tsukolsky/SeniorDesign/Files/FirstSemester/PNseries_Delorme.jpg

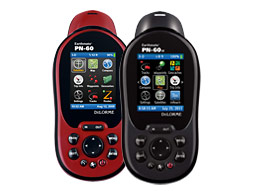
Files/FirstSemester/PNseries_Delorme.jpg
