tsukolsky/SeniorDesign/Files/FirstSemester/visualScreen.jpg

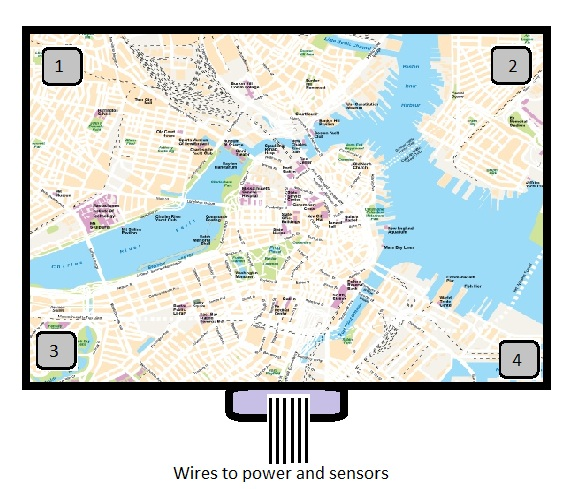
Files/FirstSemester/visualScreen.jpg
