tsukolsky/SeniorDesign/Files/powerpoints/toddsCriticalDesignReviewSlides.pptx

## Completed Items

- BeagleBone functionality
  - Modified Angstrom Kernel, boot time ~ 8 seconds. Minimal Ubuntu in ~2 seconds
  - Communication to Watchdog AVR
  - GPS Streaming, location parsing, time recognition and forwarding
- PCB schematic and layout, arrives by March 15
  - BOM ordered, arrives by March 15
- Graphics AVR functionality
  - Speed/Distance calculation using reed-switch
  - Communication from Watchdog AVR
  - HR Monitoring
  - Trip feature
- Watchdog AVR functionality
  - Real Time Clock
  - Communication from BeagleBone, to Graphics AVR
  - Battery Monitoring and power distribution
  - Temperature Sensing

## Real Time Clock UML

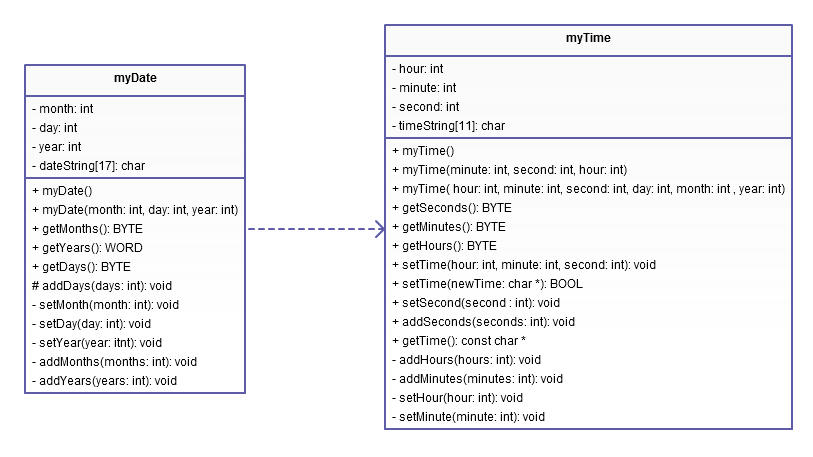
[picture p3: figure]

## Bone to WAVR Communication

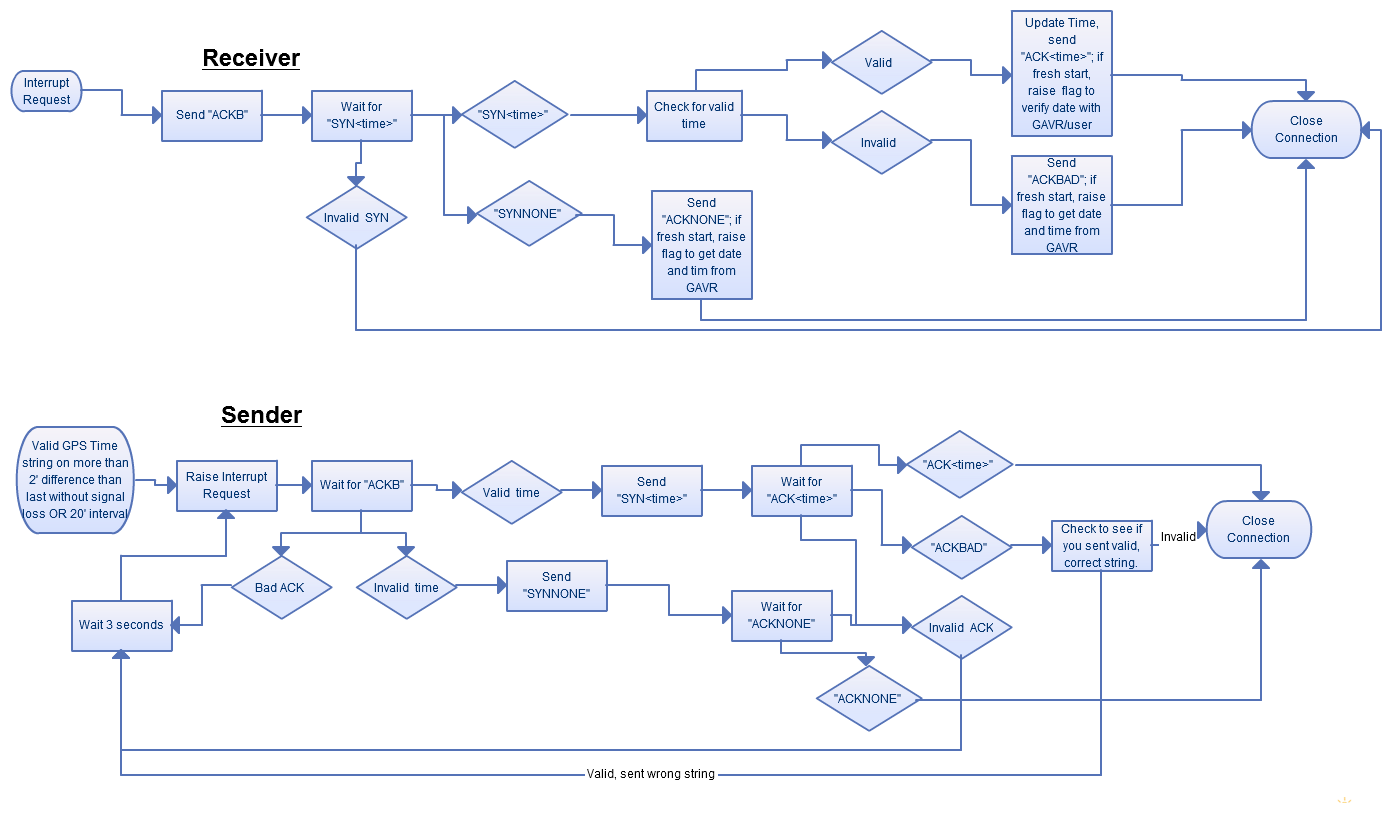
[picture p4: figure]

## WAVR to GAVR Communication

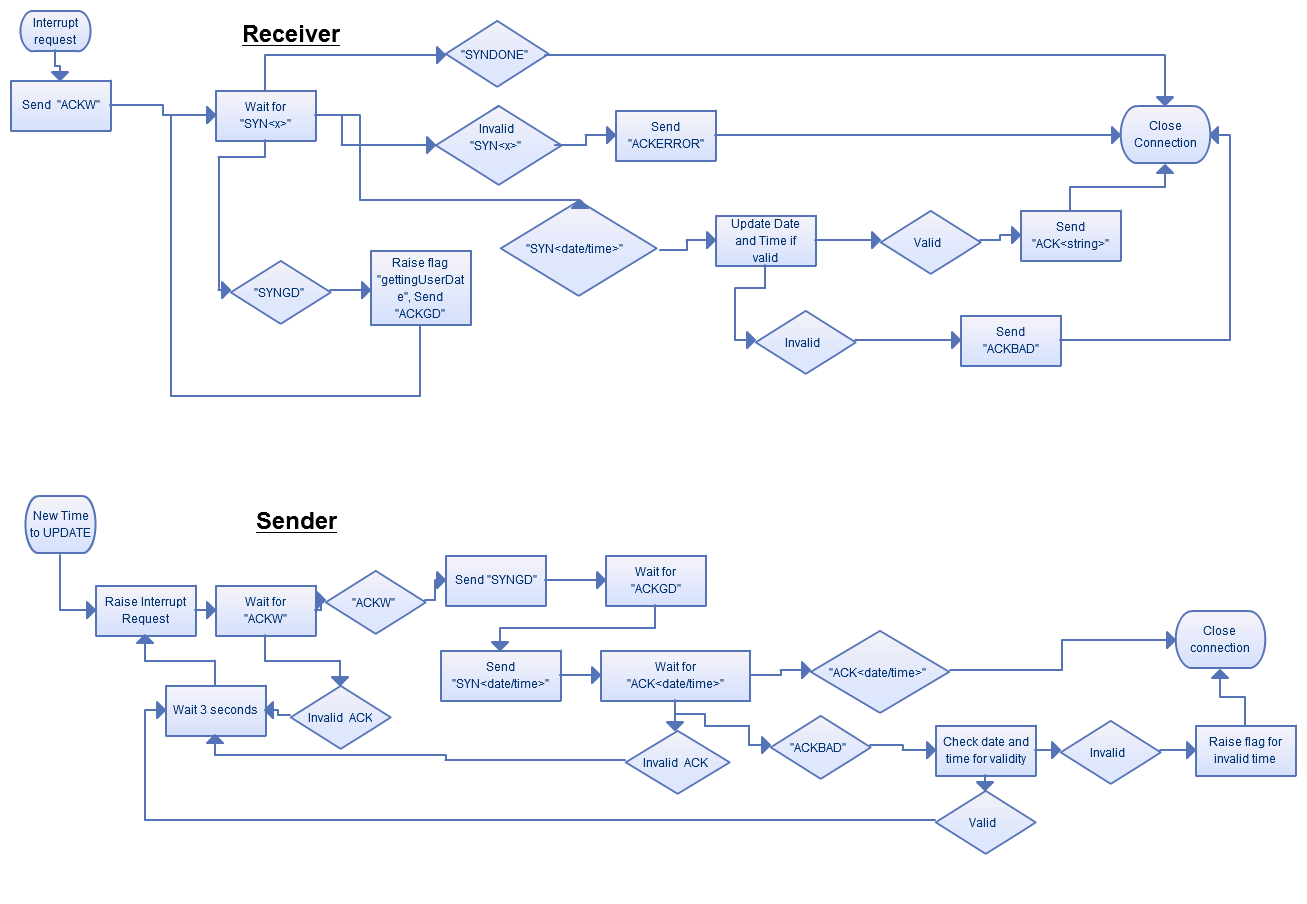
[picture p5: figure]

## Trip Feature UML

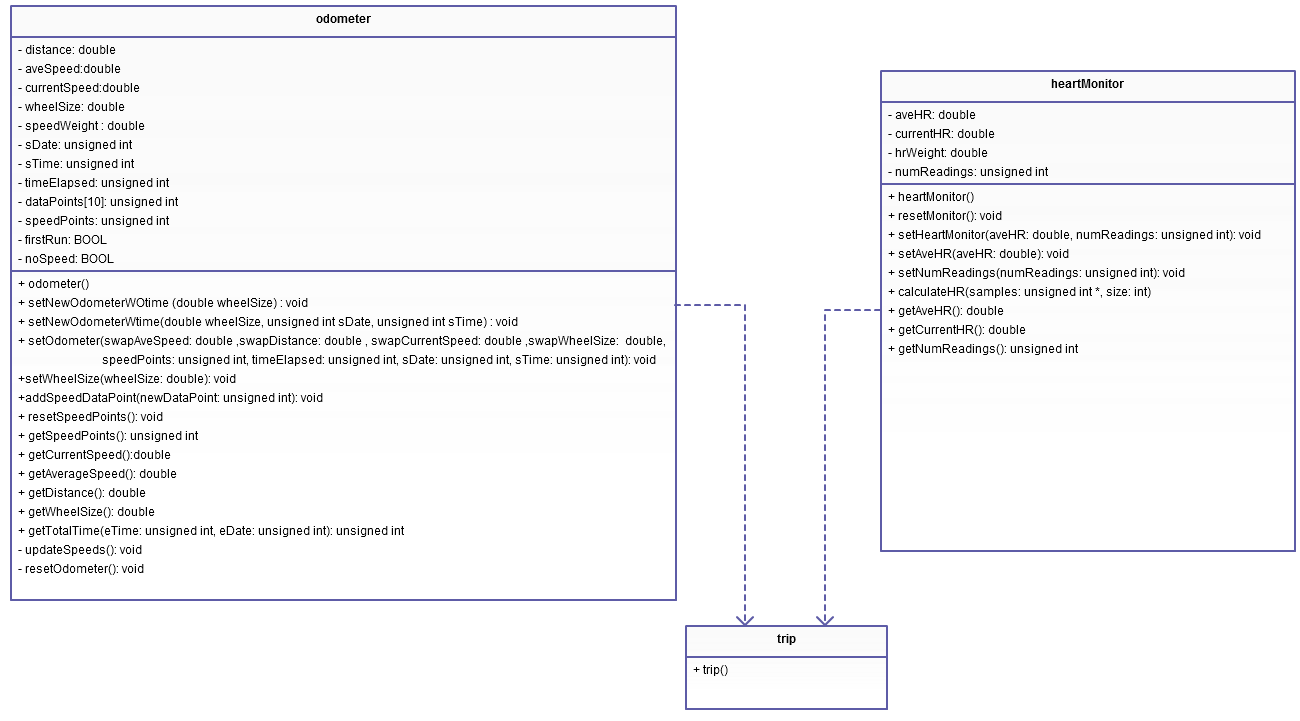
[picture p6: figure]

## Trip Flow and Data Structure

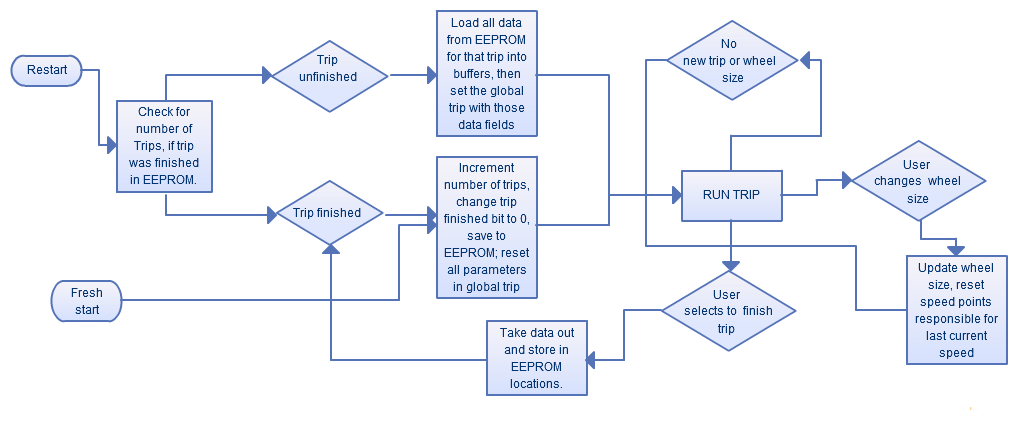
[picture p7: figure]
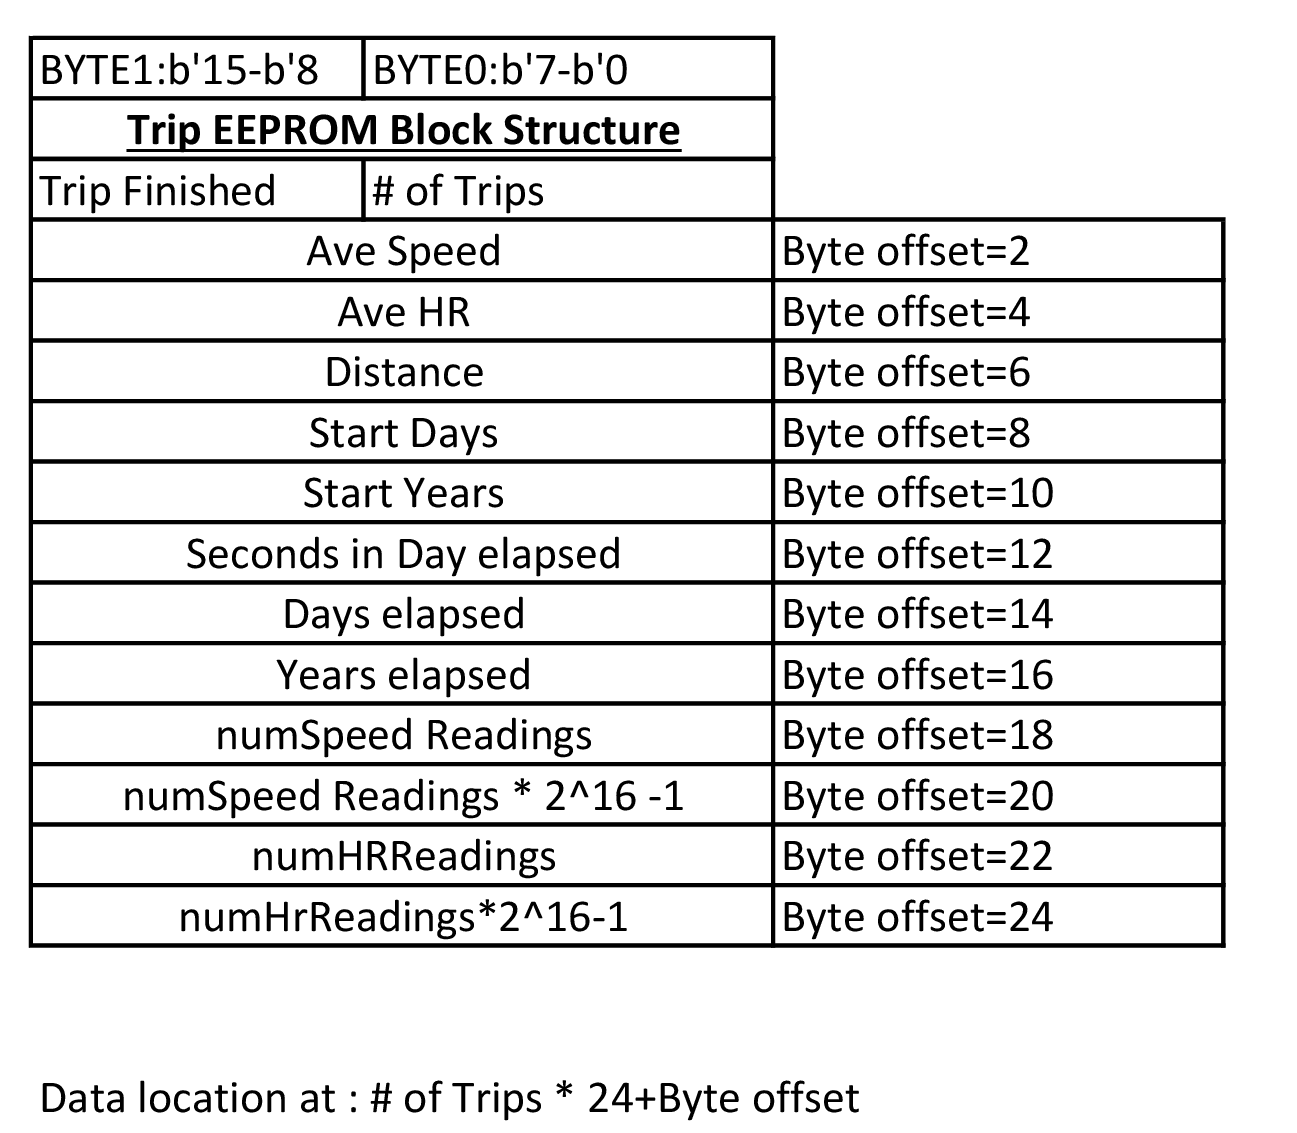
[picture p8: figure]

## Slide 7

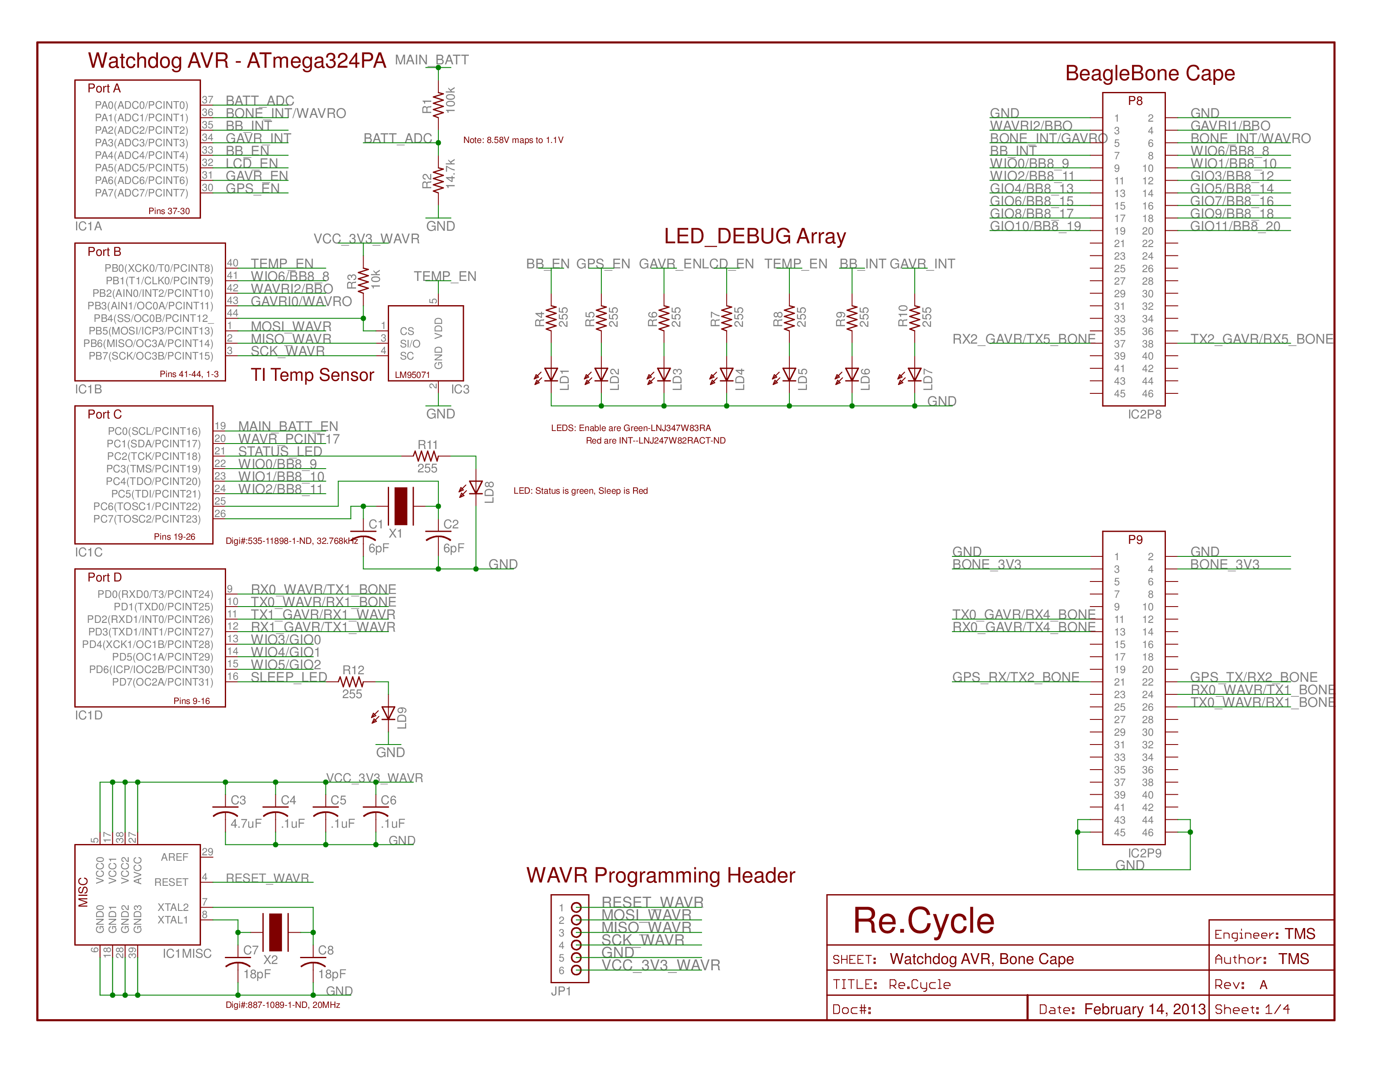
[picture p9: figure]

## Slide 8

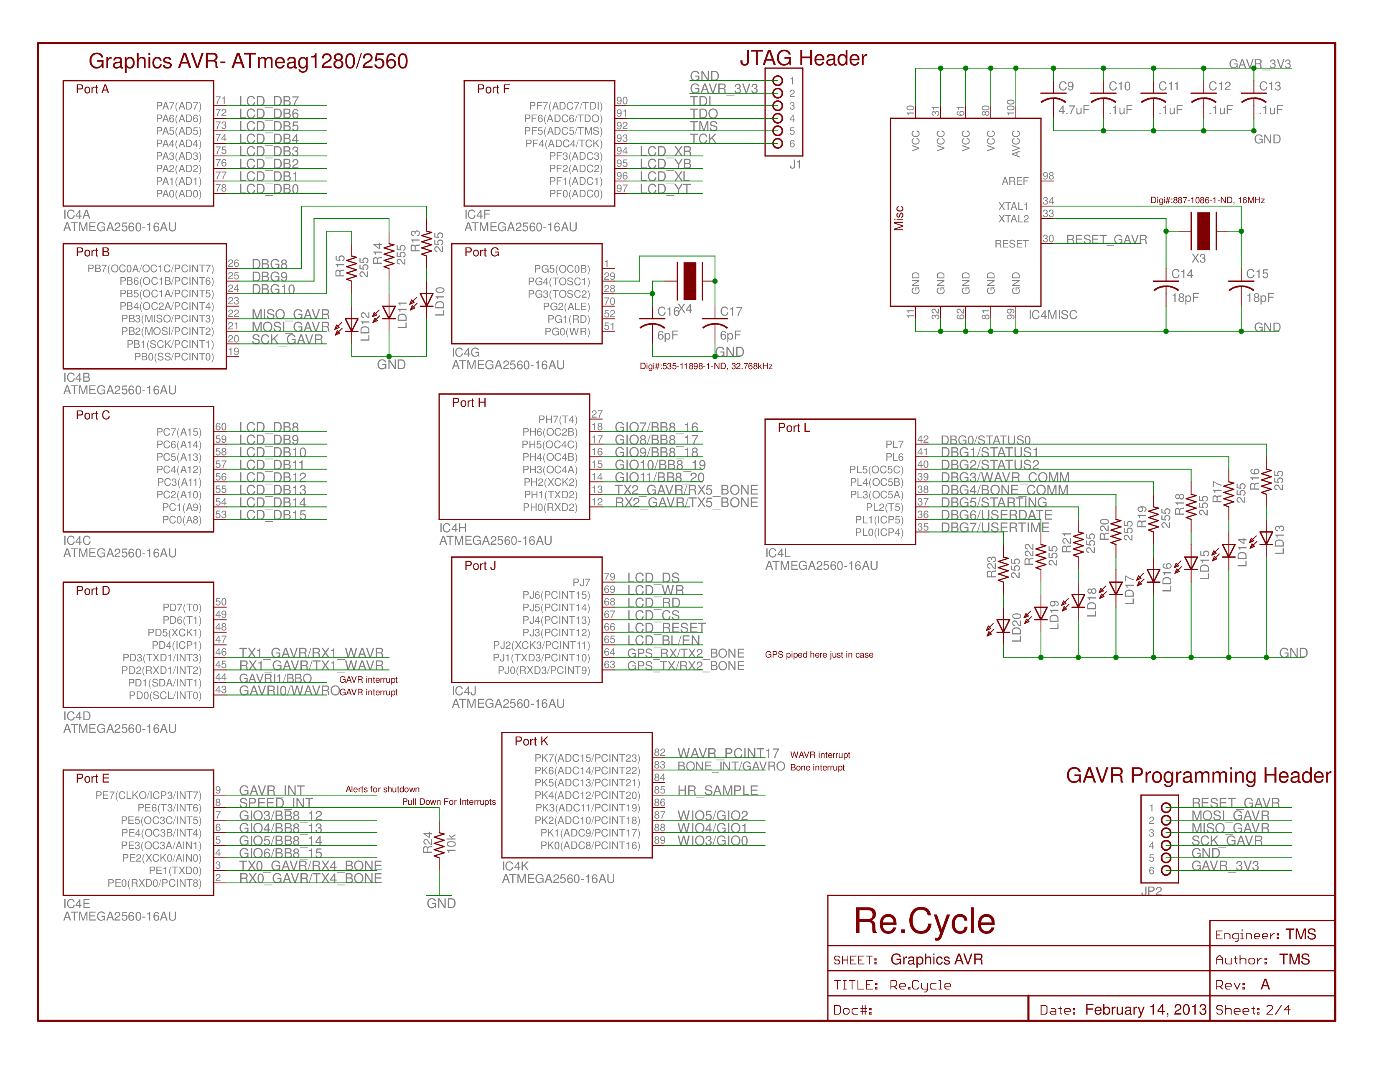
[picture p10: figure]

## Slide 9

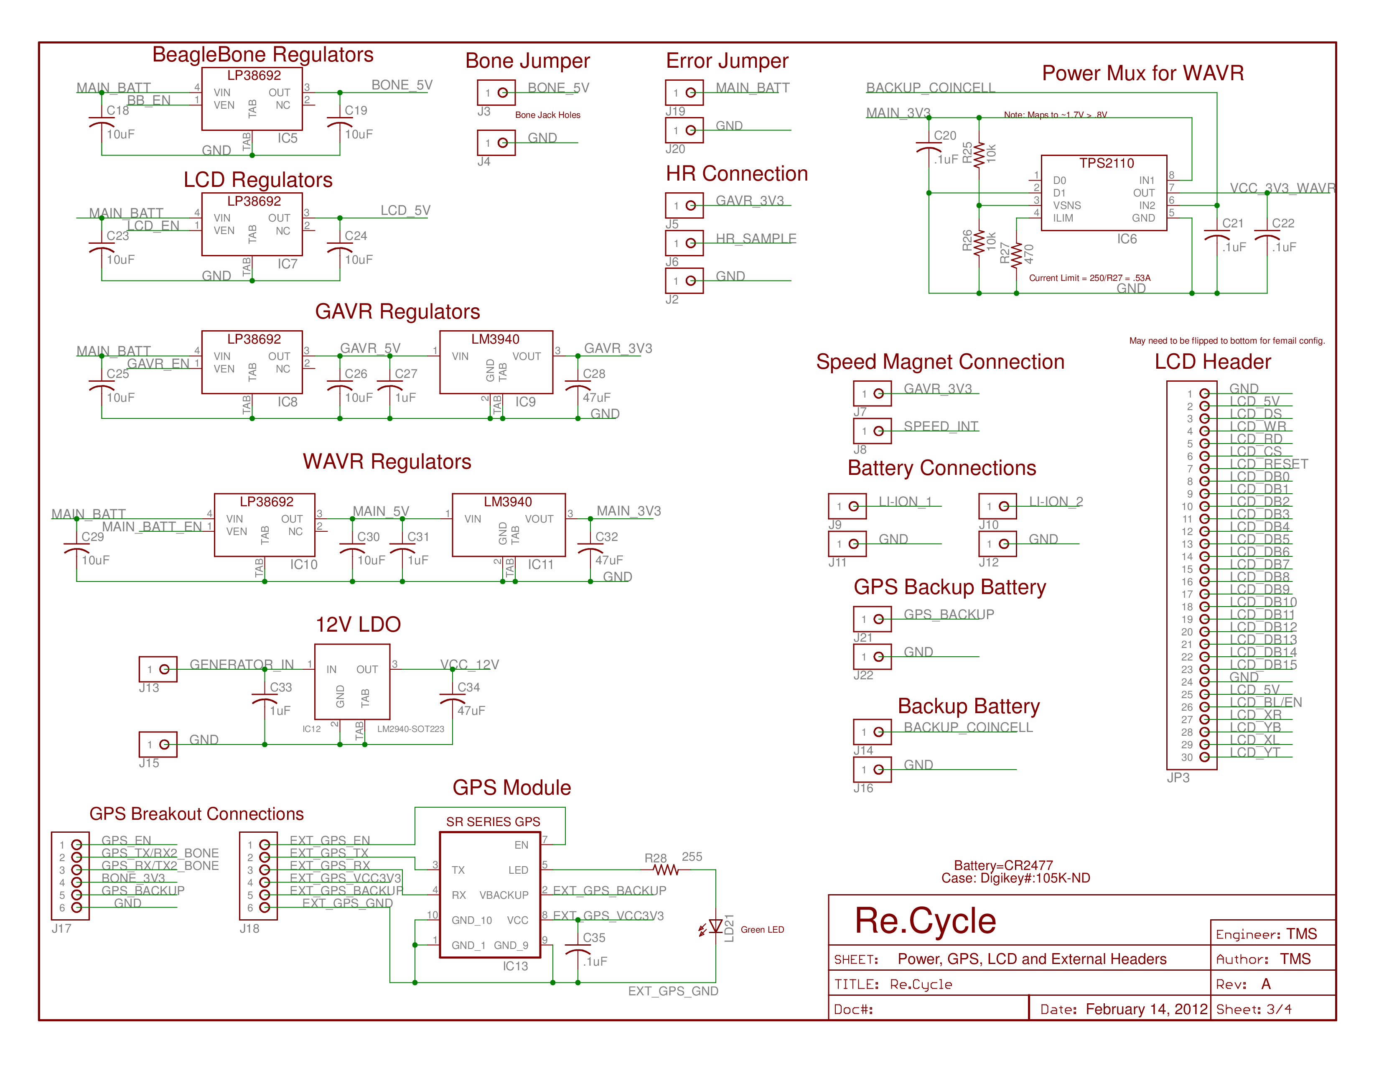
[picture p11: figure]

## Slide 10

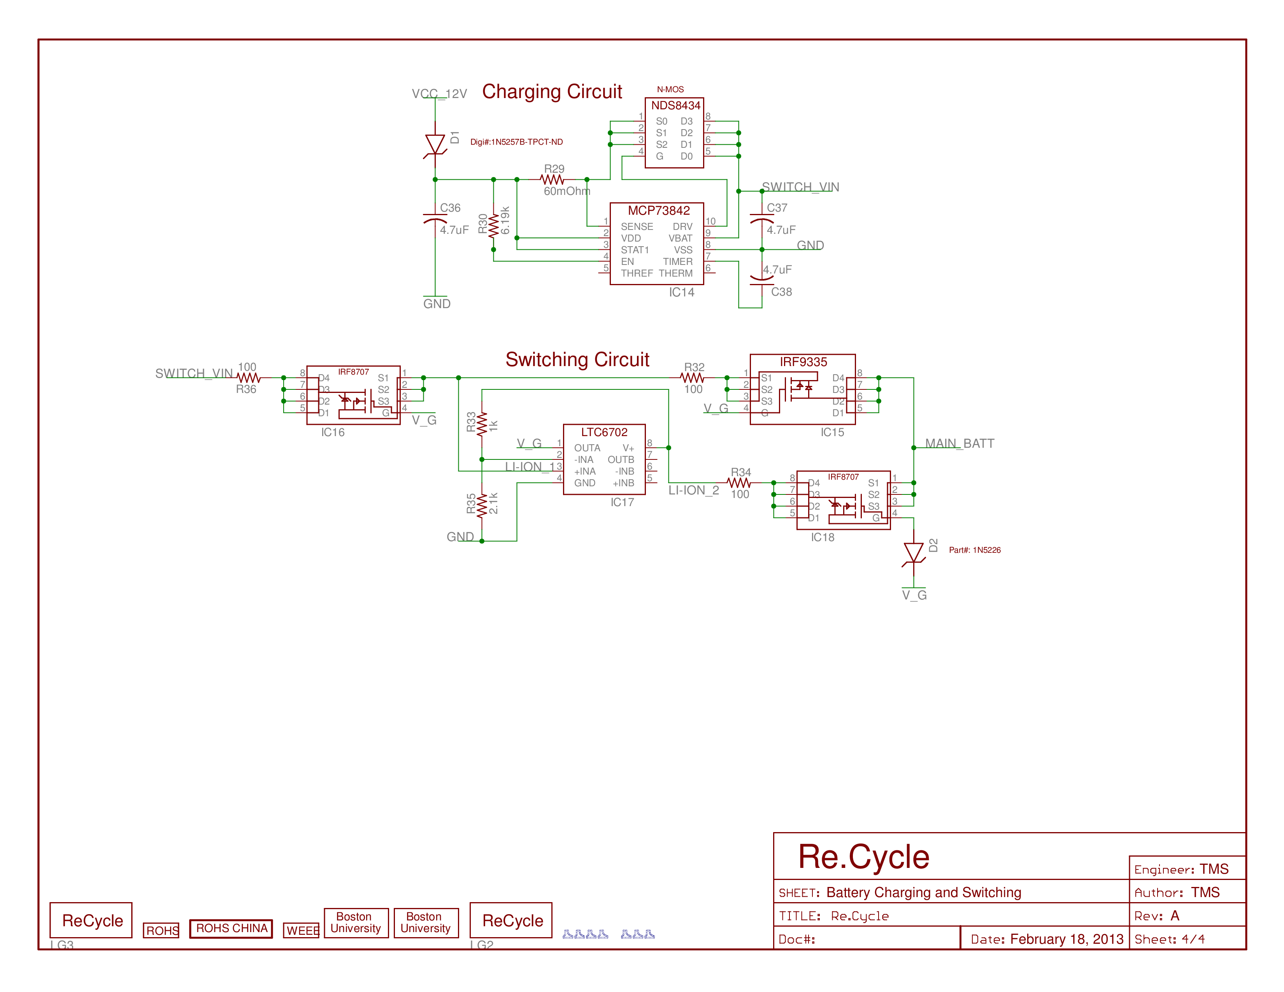
[picture p12: figure]

## Slide 11

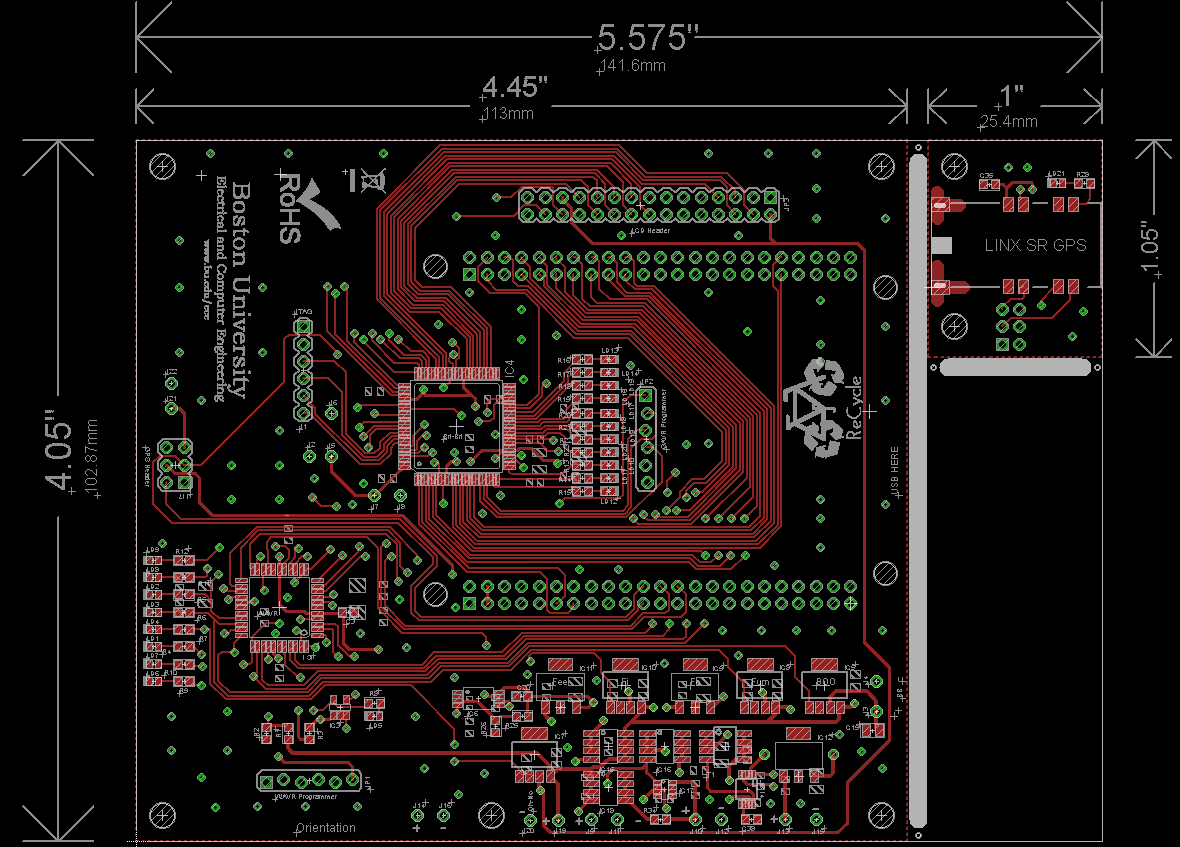
[picture p13: figure]

## Slide 12

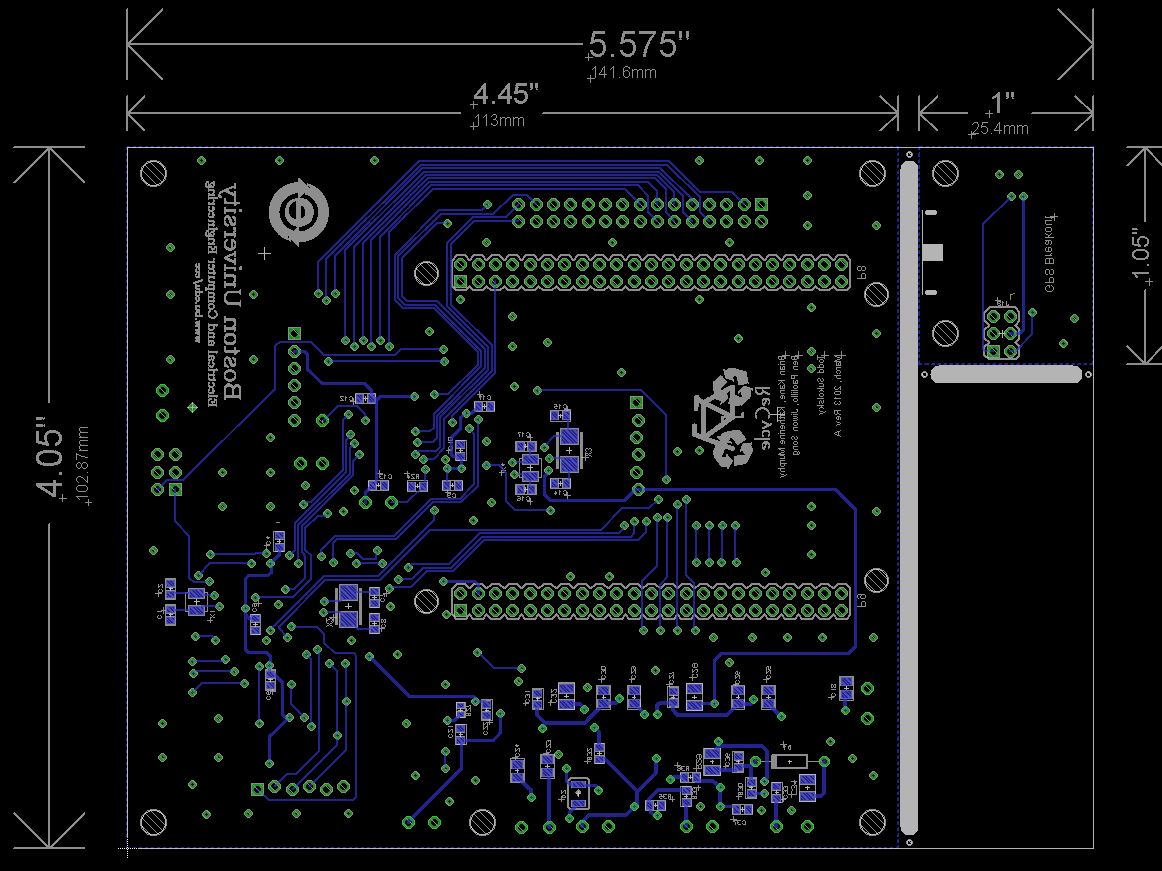
[picture p14: figure]

## In Progress Items…

- Watchdog AVR
  - Communication from Graphics AVR
- Graphics AVR
  - Communication to Graphics AVR, two-way communication with BeagleBone
  - Restart procedure for trip data stored in EEPROM
  - Full integration of all modules, currently two or three run together instead of all six or seven
- BeagleBone
  - Final implementation of communication usb-dump scripts in startup sequence.
  - Communication with GAVR
- PCB population and testing
- Casing

## Casing

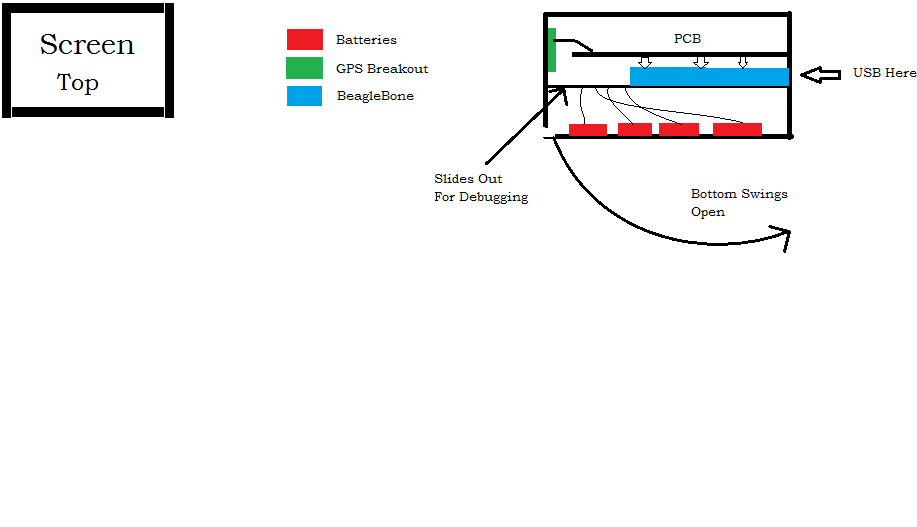
[picture p15: figure]

- Six sheets of ¼” thick Polycarbonate
- Machined in BU Machine Shop
- Designed in Solidworks
- Bottom swings out to allow easy access for batteries, BeagleBone mounted on inner sheet that slides out for debugging.

## GAVR to WAVR Communication

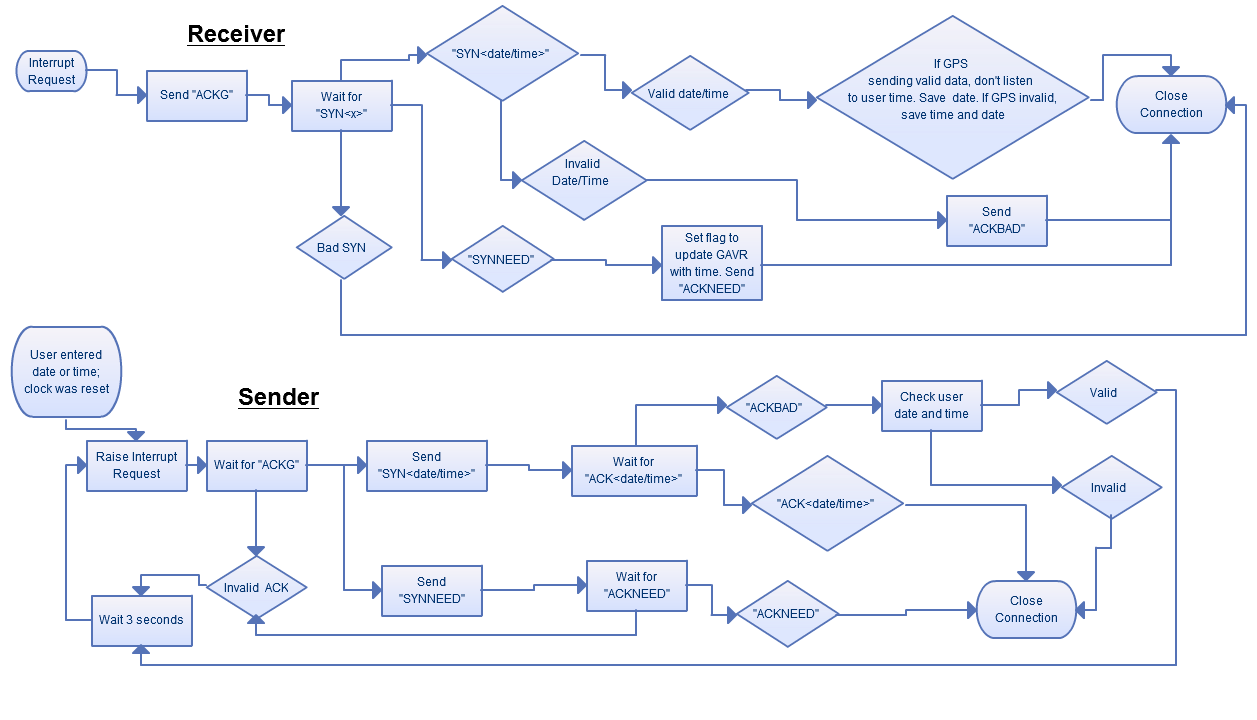
[picture p16: figure]
