tsukolsky/SeniorDesign/Files/PDF/TripFeatures.pdf

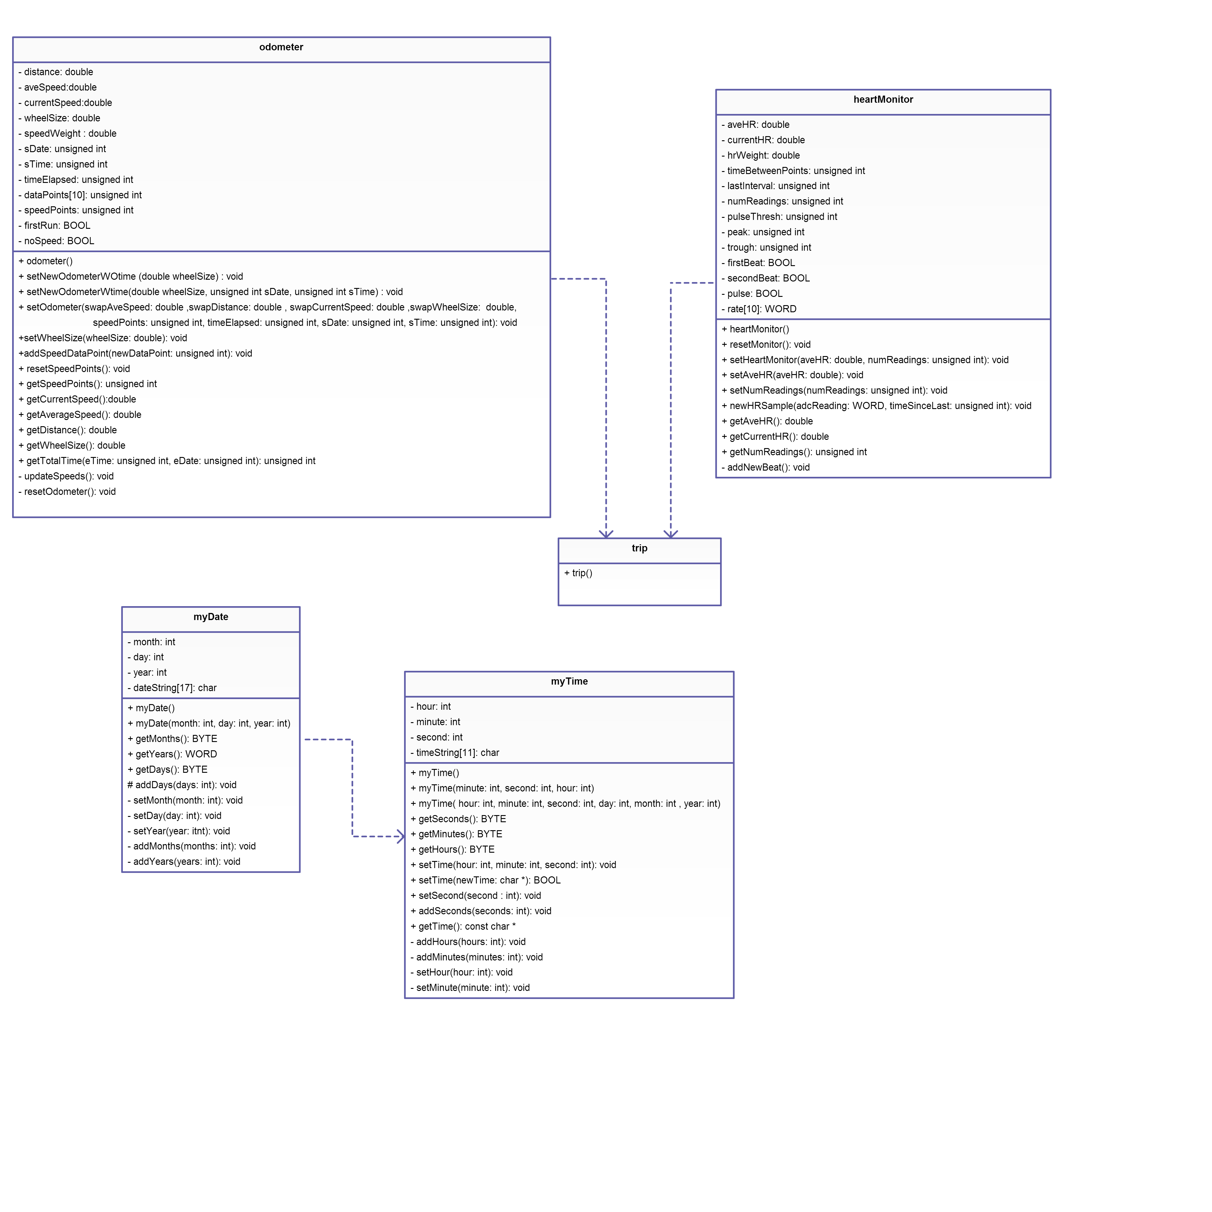
[picture p40: page 1]
