tsukolsky/SeniorDesign/Files/finalDigikey.PNG

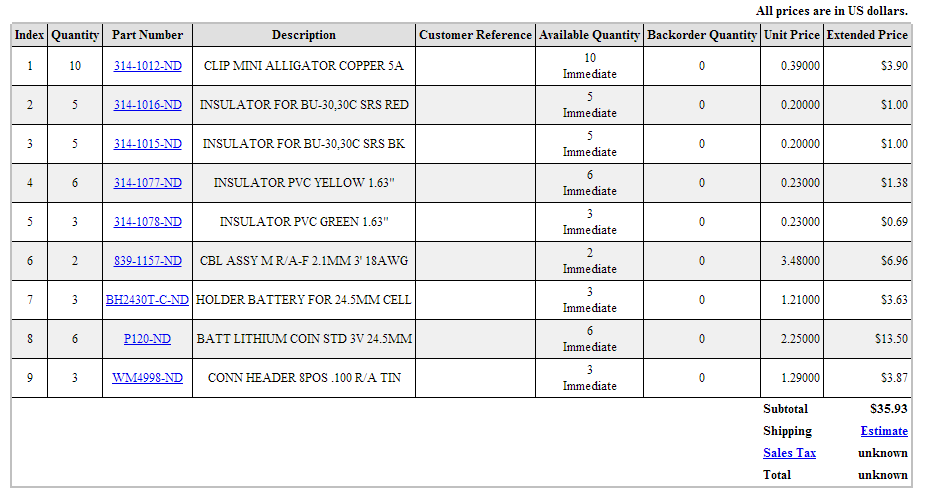
Files/finalDigikey.PNG
