tsukolsky/SeniorDesign/Files/FirstSemester/bicycle.jpg

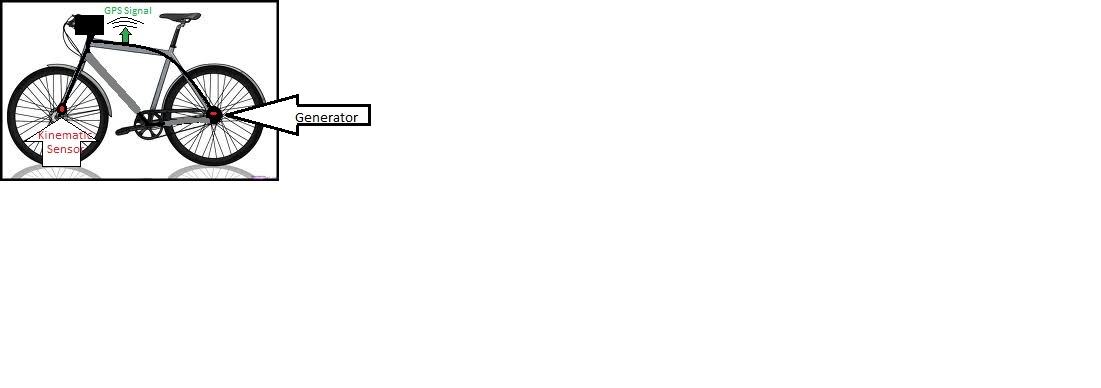
Files/FirstSemester/bicycle.jpg
