tsukolsky/SeniorDesign/Files/FirstSemester/Top view.png

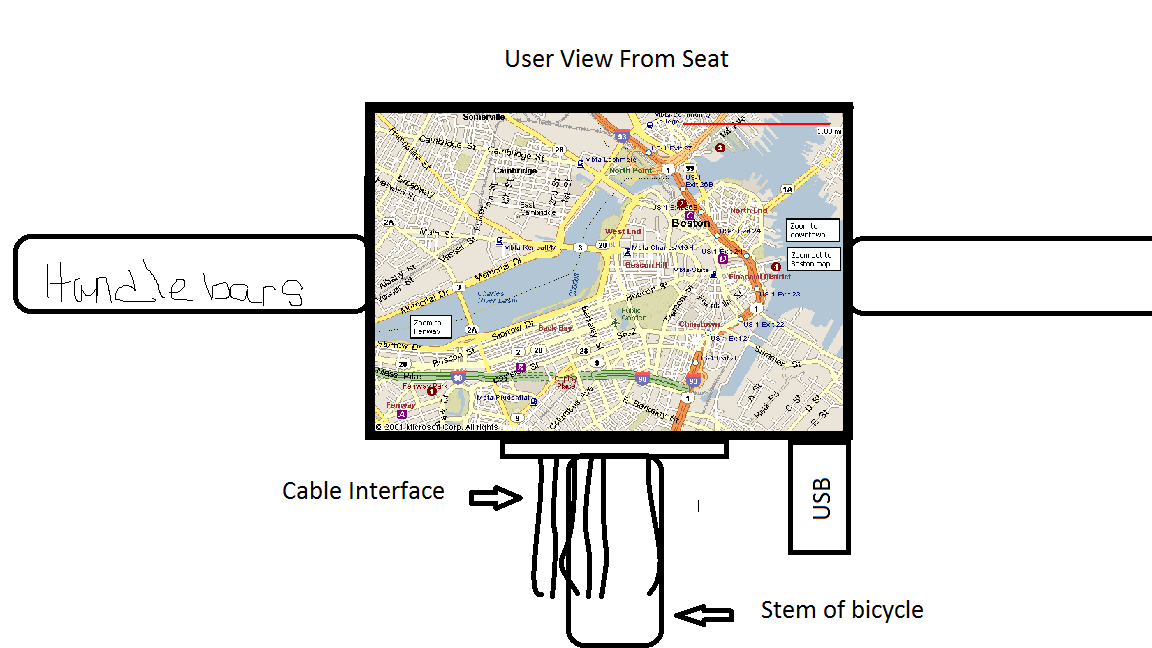
Files/FirstSemester/Top view.png
