tsukolsky/SeniorDesign/Files/PNGs/depends.png

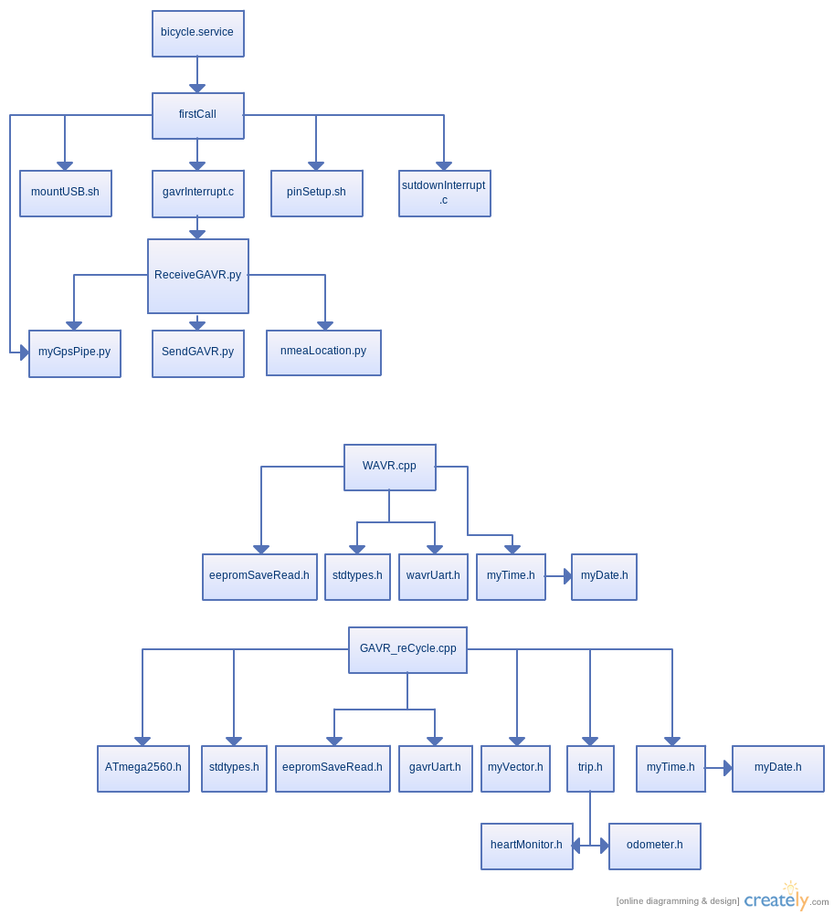
Files/PNGs/depends.png
