tsukolsky/SeniorDesign/Files/PNGs/Re.Cycle_bottom.png

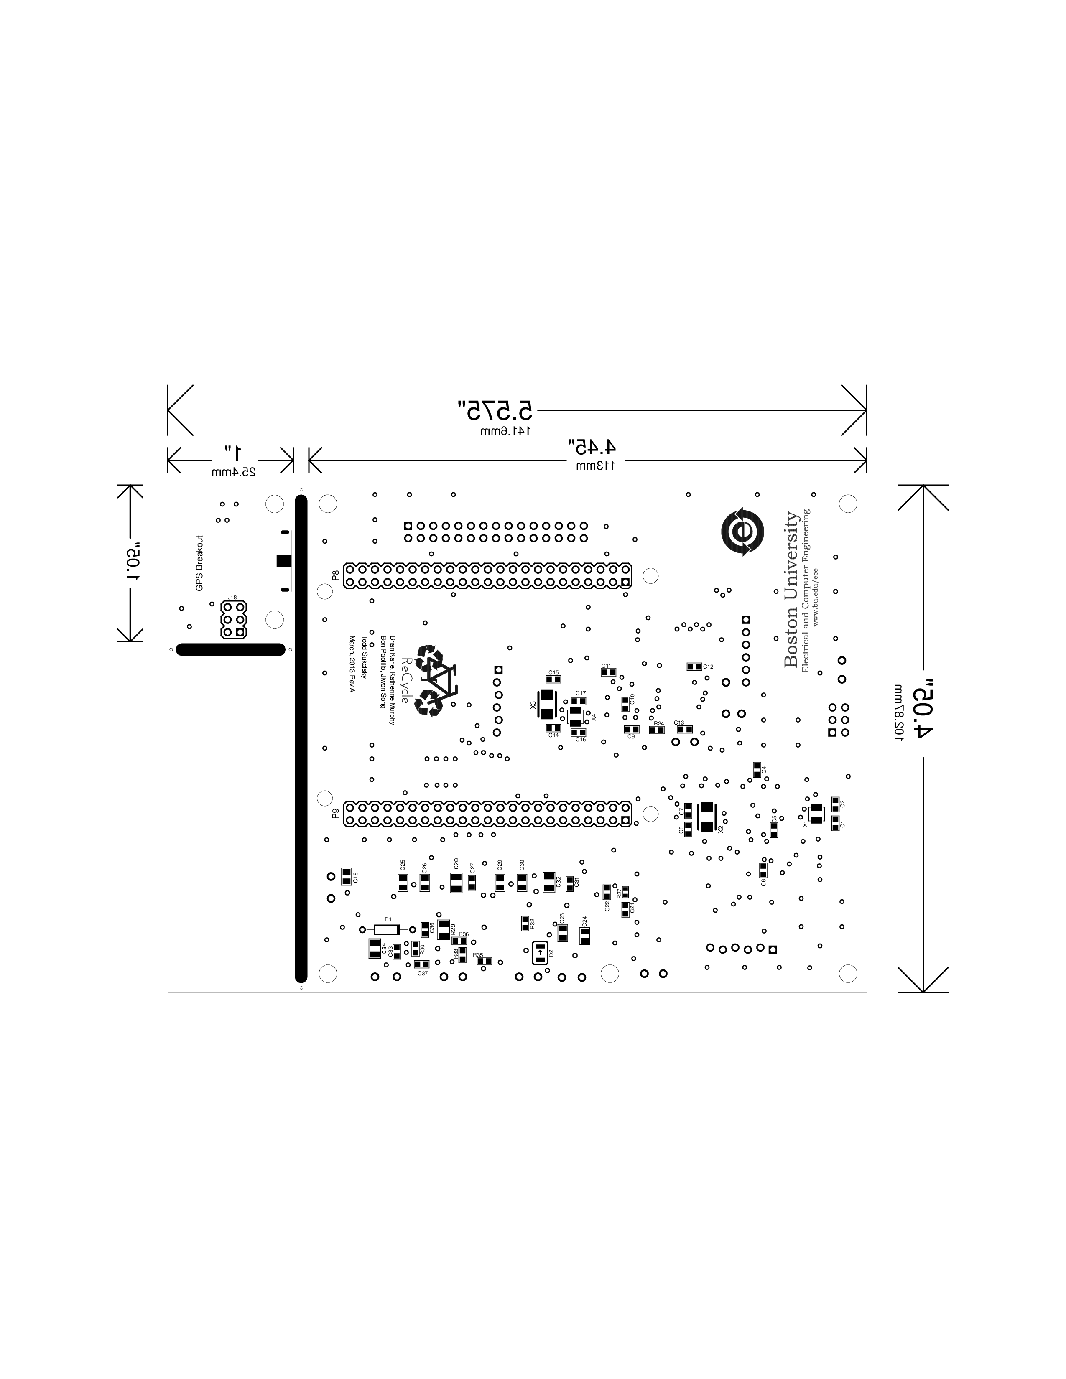
Files/PNGs/Re.Cycle_bottom.png
