tsukolsky/SeniorDesign/Files/PNGs/Re.Cycle_top.png

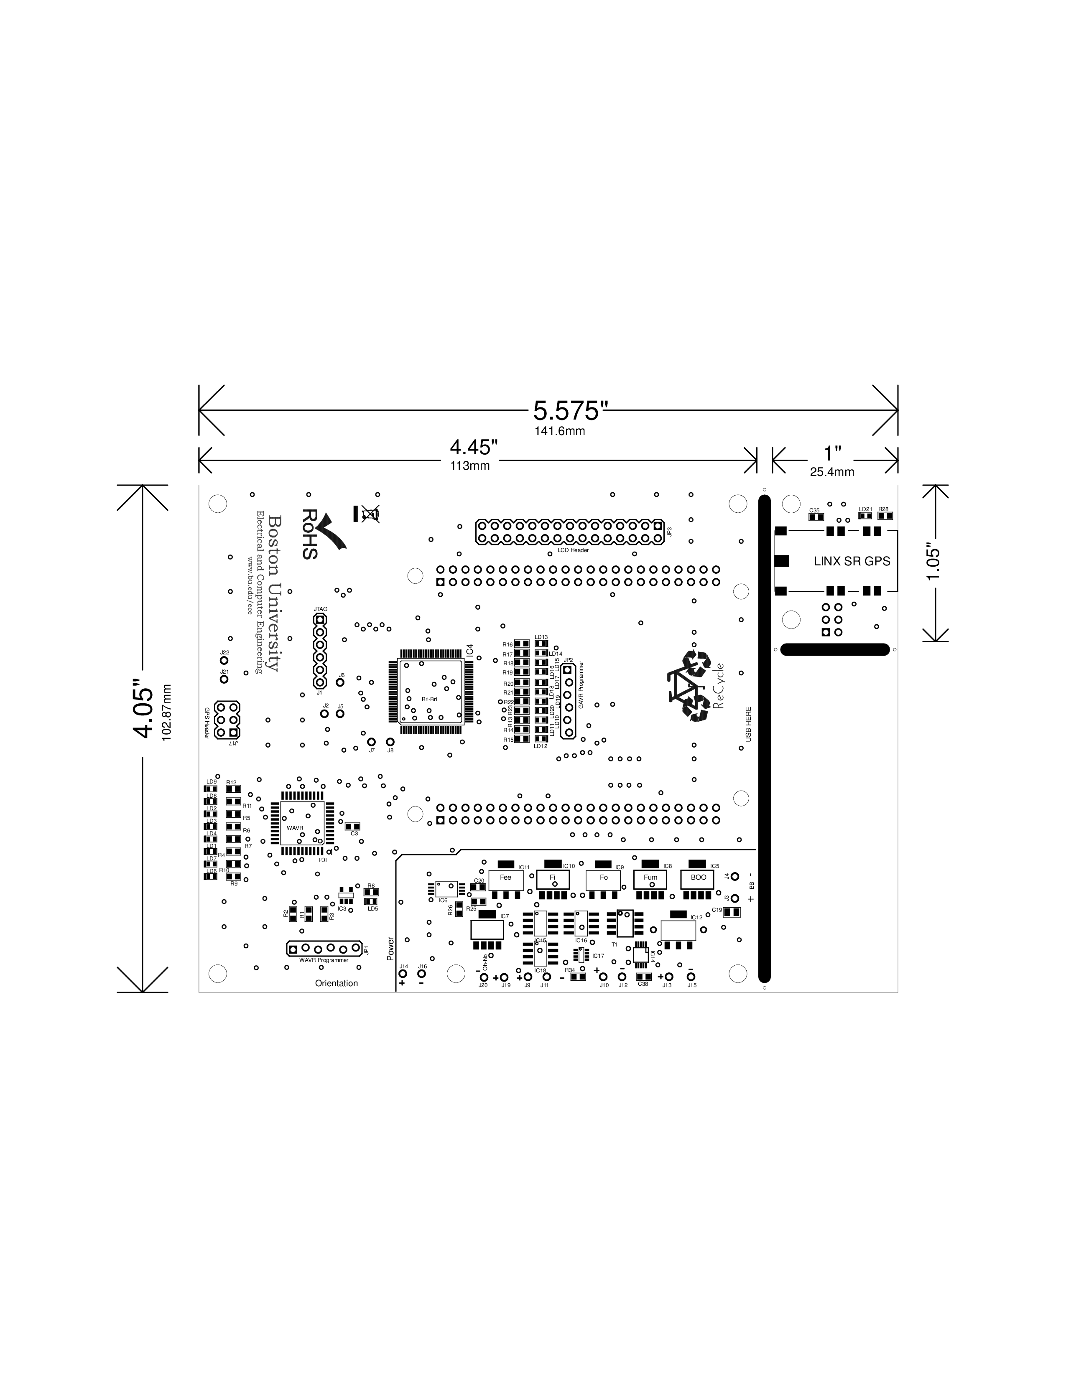
Files/PNGs/Re.Cycle_top.png
