tsukolsky/SeniorDesign/Files/TIorder.JPG

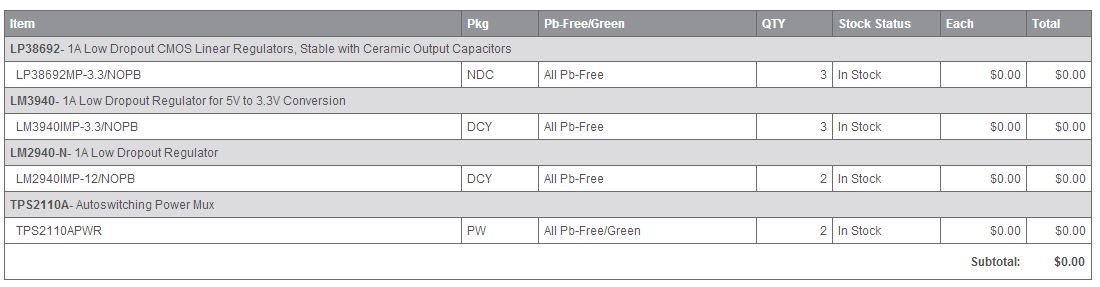
Files/TIorder.JPG
