tsukolsky/SeniorDesign/ResourceCD/Team14-ECE464 2013/Software Documentation/Documentation/BeagleBoneFlow.jpg

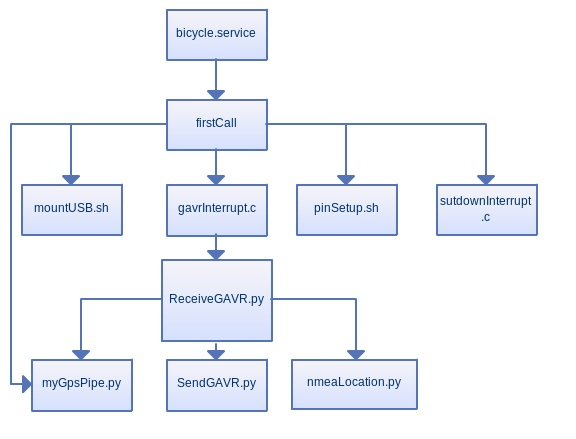
ResourceCD/Team14-ECE464 2013/Software Documentation/Documentation/BeagleBoneFlow.jpg
