tsukolsky/SeniorDesign/ResourceCD/Team14-ECE464 2013/Software Documentation/Documentation/GAVRflow.jpg

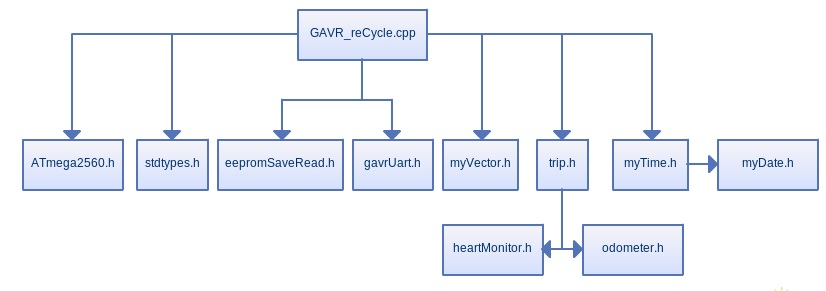
ResourceCD/Team14-ECE464 2013/Software Documentation/Documentation/GAVRflow.jpg
