tsukolsky/SeniorDesign/ResourceCD/Team14-ECE464 2013/Software Documentation/Documentation/WAVRflow.png

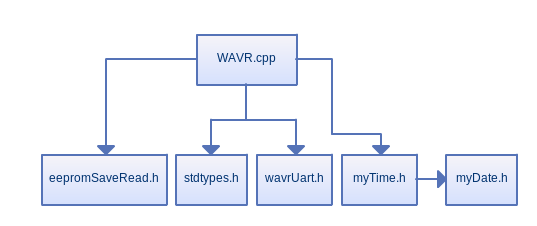
ResourceCD/Team14-ECE464 2013/Software Documentation/Documentation/WAVRflow.png
