tsukolsky/SeniorDesign/ResourceCD/Team14-ECE464 2013/Hardware Documentation/CAD-CAM Files/SolidworksCasing/Assembly.SLDASM

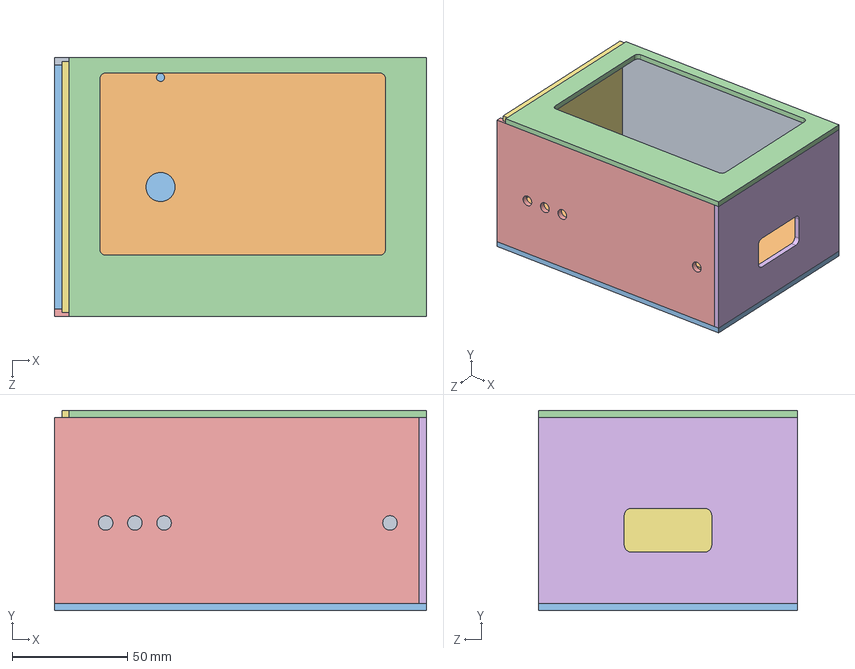
[picture p51: CAD file, 2013-04-29]
ResourceCD/Team14-ECE464 2013/Hardware Documentation/CAD-CAM Files/SolidworksCasing/Assembly.SLDASM
161.7 x 87.0 x 112.4 mm
Wall 1
Shelf
Base
Top
Wall 2, holes
Wall USB
Wall 3
