tsukolsky/SeniorDesign/ResourceCD/Team14-ECE464 2013/Hardware Documentation/CAD-CAM Files/SolidworksCasing/Wall USB.SLDPRT

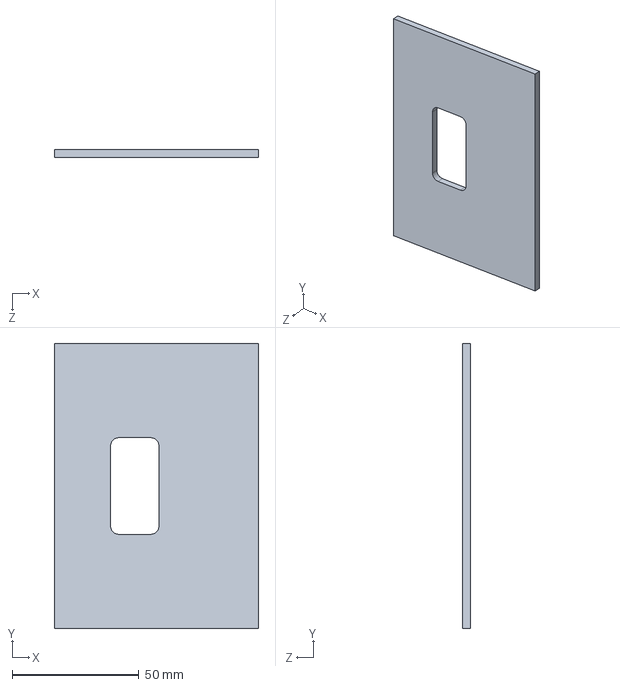
[picture p52: CAD file, 2013-04-29]
ResourceCD/Team14-ECE464 2013/Hardware Documentation/CAD-CAM Files/SolidworksCasing/Wall USB.SLDPRT
80.6 x 112.4 x 3.17 mm
