tsukolsky/SeniorDesign/ResourceCD/Team14-ECE464 2013/Hardware Documentation/CAD-CAM Files/SolidworksCasing/Wall 1.SLDPRT

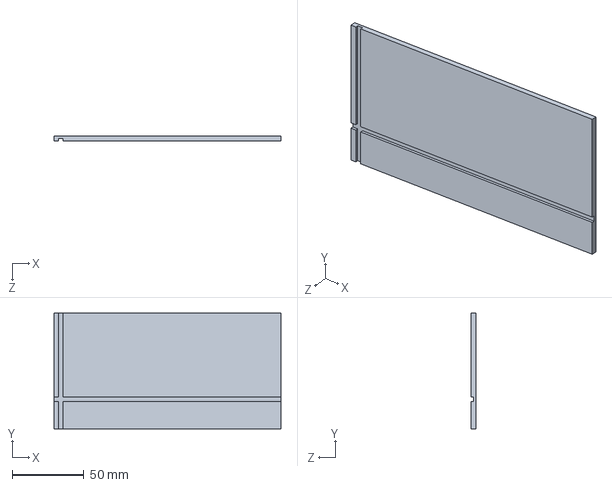
[picture p53: CAD file, 2013-04-29]
ResourceCD/Team14-ECE464 2013/Hardware Documentation/CAD-CAM Files/SolidworksCasing/Wall 1.SLDPRT
158.5 x 80.6 x 3.17 mm
