tsukolsky/SeniorDesign/ResourceCD/Team14-ECE464 2013/Hardware Documentation/CAD-CAM Files/SolidworksCasing/Wall 3.SLDPRT

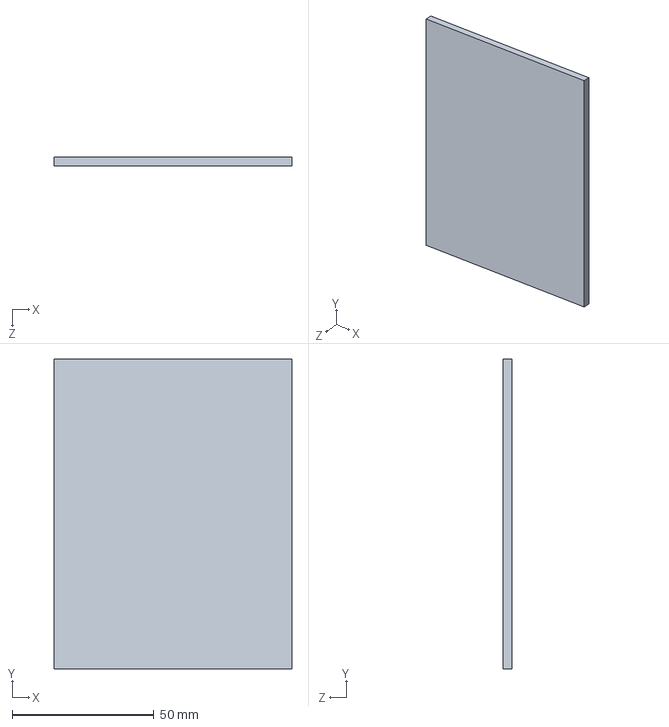
[picture p54: CAD file, 2013-04-29]
ResourceCD/Team14-ECE464 2013/Hardware Documentation/CAD-CAM Files/SolidworksCasing/Wall 3.SLDPRT
83.8 x 109.2 x 3.17 mm
