tsukolsky/SeniorDesign/ResourceCD/Team14-ECE464 2013/Hardware Documentation/CAD-CAM Files/SolidworksCasing/Base.SLDPRT

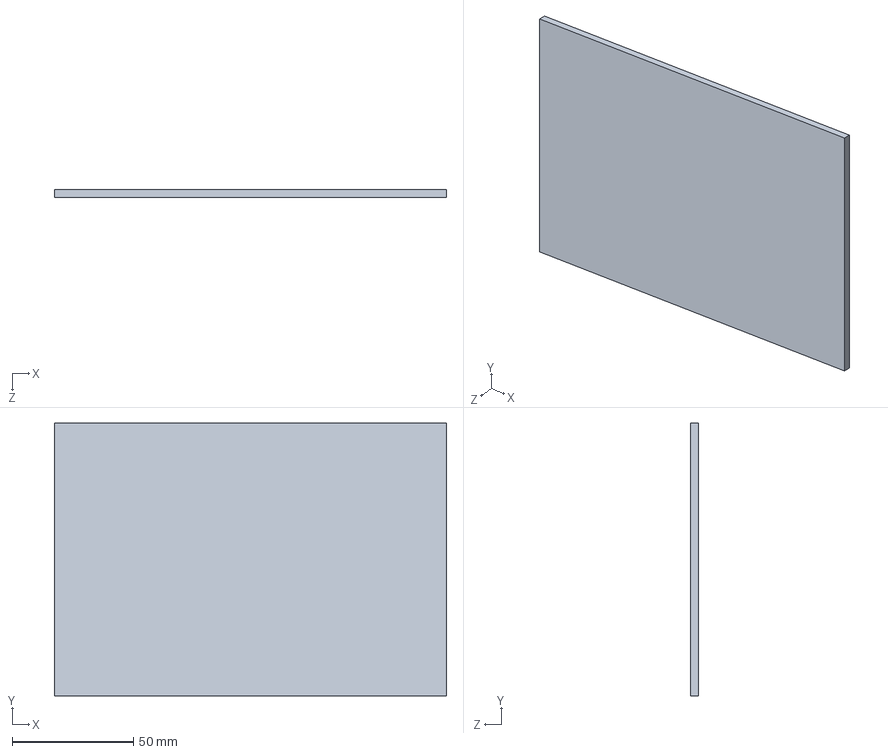
[picture p55: CAD file, 2013-04-29]
ResourceCD/Team14-ECE464 2013/Hardware Documentation/CAD-CAM Files/SolidworksCasing/Base.SLDPRT
161.7 x 112.4 x 3.17 mm
