tsukolsky/SeniorDesign/(list of files, cad)

Other CAD files:
ResourceCD/Team14-ECE464 2013/Hardware Documentation/CAD-CAM Files/SolidworksCasing/Wall 2, holes.SLDPRT
