tsukolsky/SeniorDesign/ResourceCD/Team14-ECE464 2013/Hardware Documentation/Schematics and PCB/Re.Cycle_top.pdf

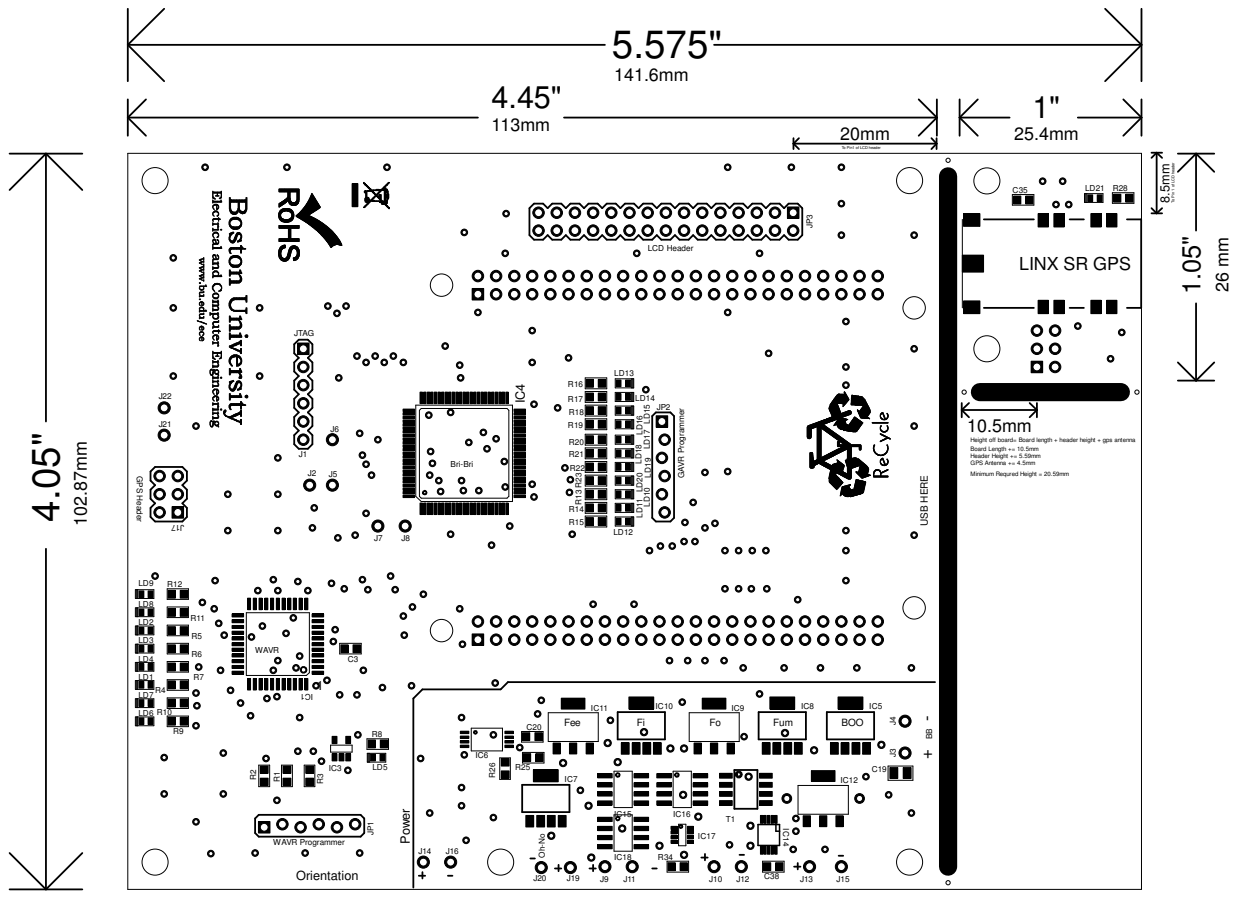
[picture p62: page 1]

To Pin1 of LCD header

To Pin 1 of LCD header

Height off board= Board length + header height + gps antenna
Board Length += 10.5mm
Header Height += 5.59mm
GPS Antenna += 4.5mm
Minimum Requred Height = 20.59mm
