tsukolsky/SeniorDesign/ResourceCD/Team14-ECE464 2013/Hardware Documentation/Schematics and PCB/Re.Cycle_sch.pdf

GND | GND

### GND

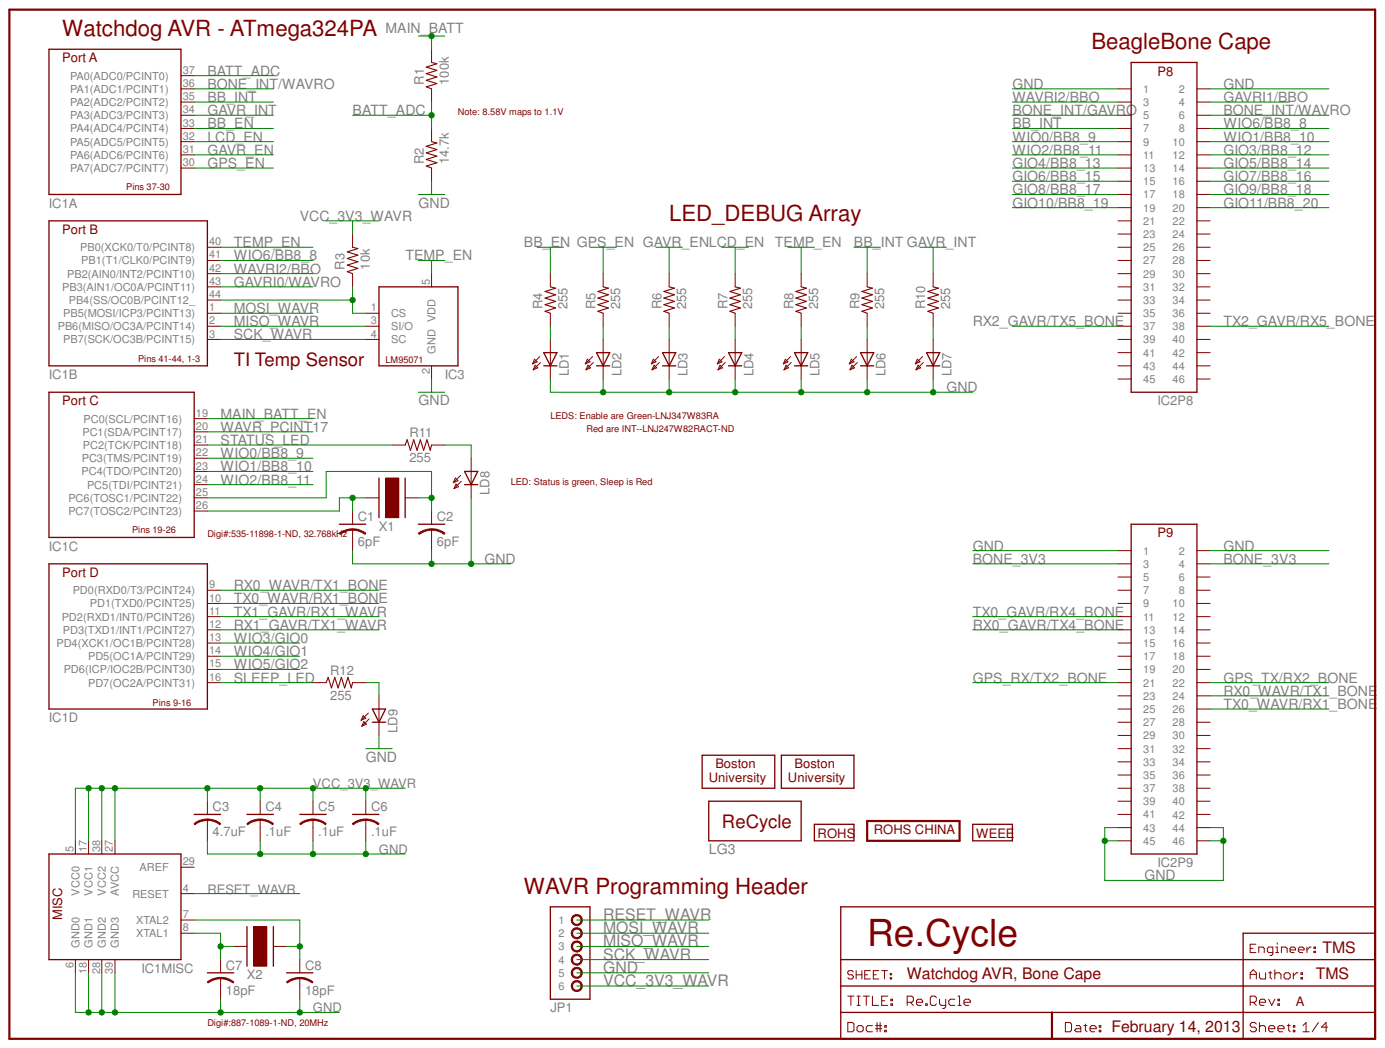
[picture p63: page 1]

LEDS: Enable are Green-LNJ347W83RA

Red are INT--LNJ247W82RACT-ND

LED: Status is green, Sleep is Red

Watchdog AVR, Bone Cape

### GND GAVR_3V3

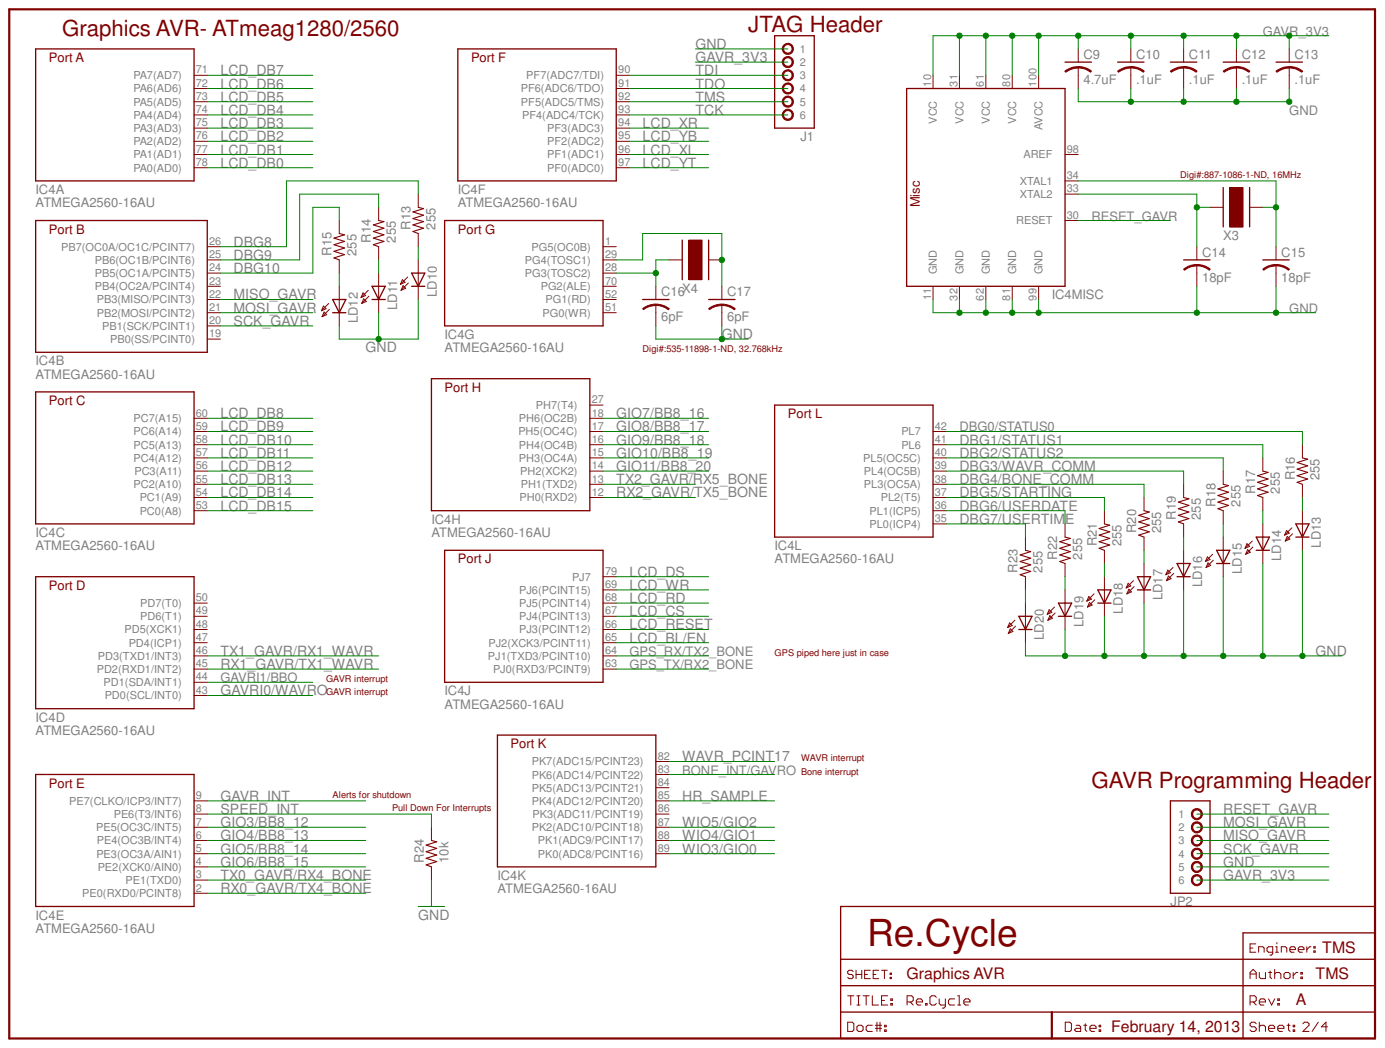
[picture p64: page 2]

GPS piped here just in case

WAVR interrupt
GAVR Programming Header Bone interrupt

Pull Down For Interrupts

IC6

IC5

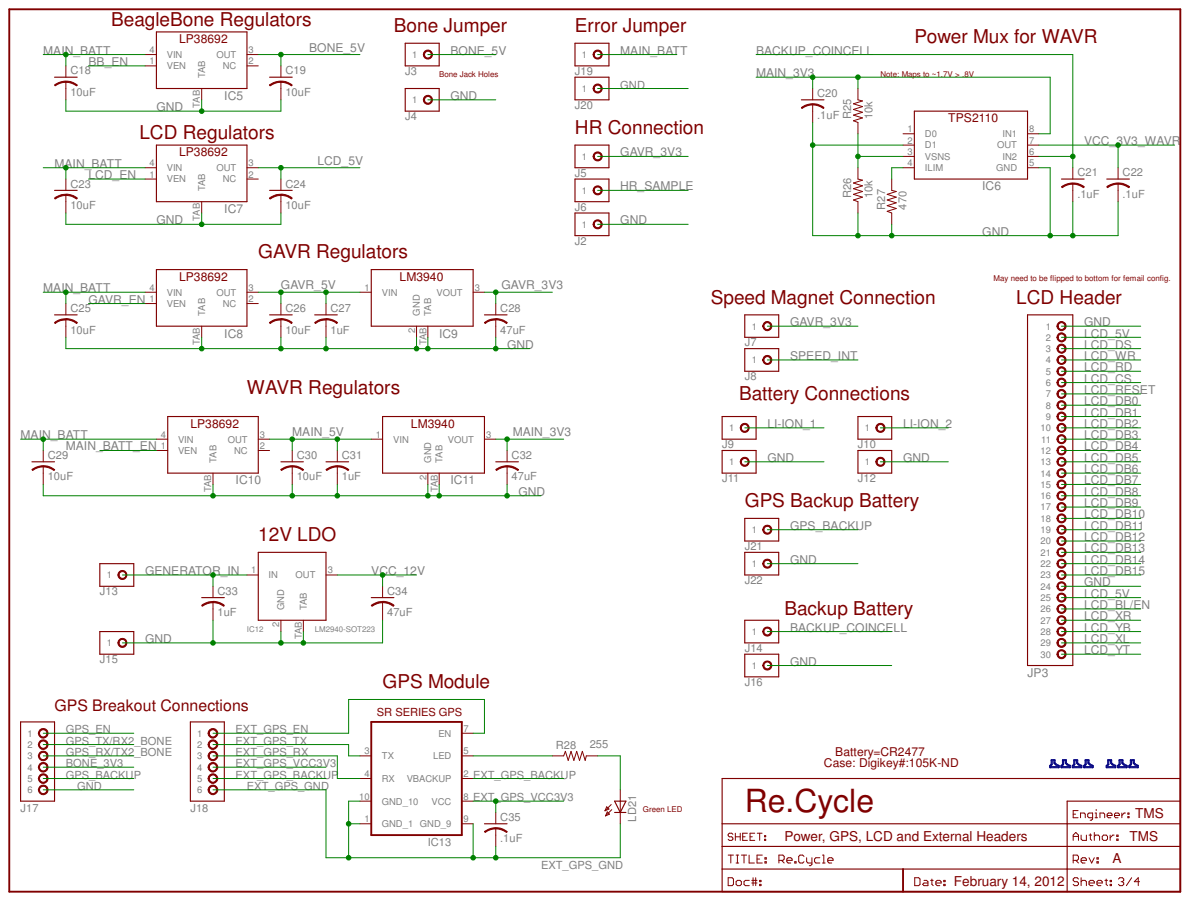
[picture p65: page 3]

Power Mux for WAVR BeagleBone Regulators

GAVR Regulators

May need to be flipped to bottom for femail config.
LCD Header

GPS_TX/RX2_BONE | EXT_GPS_TX | | 5
GPS_RX/TX2_BONE | EXT_GPS_RX
BONE_3V3 | EXT_GPS_VCC3V3 | 4

Battery=CR2477 Case: Digikey#:105K-ND
Re.Cycle

Power, GPS, LCD and External Headers

### GND

### SWITCH_VIN

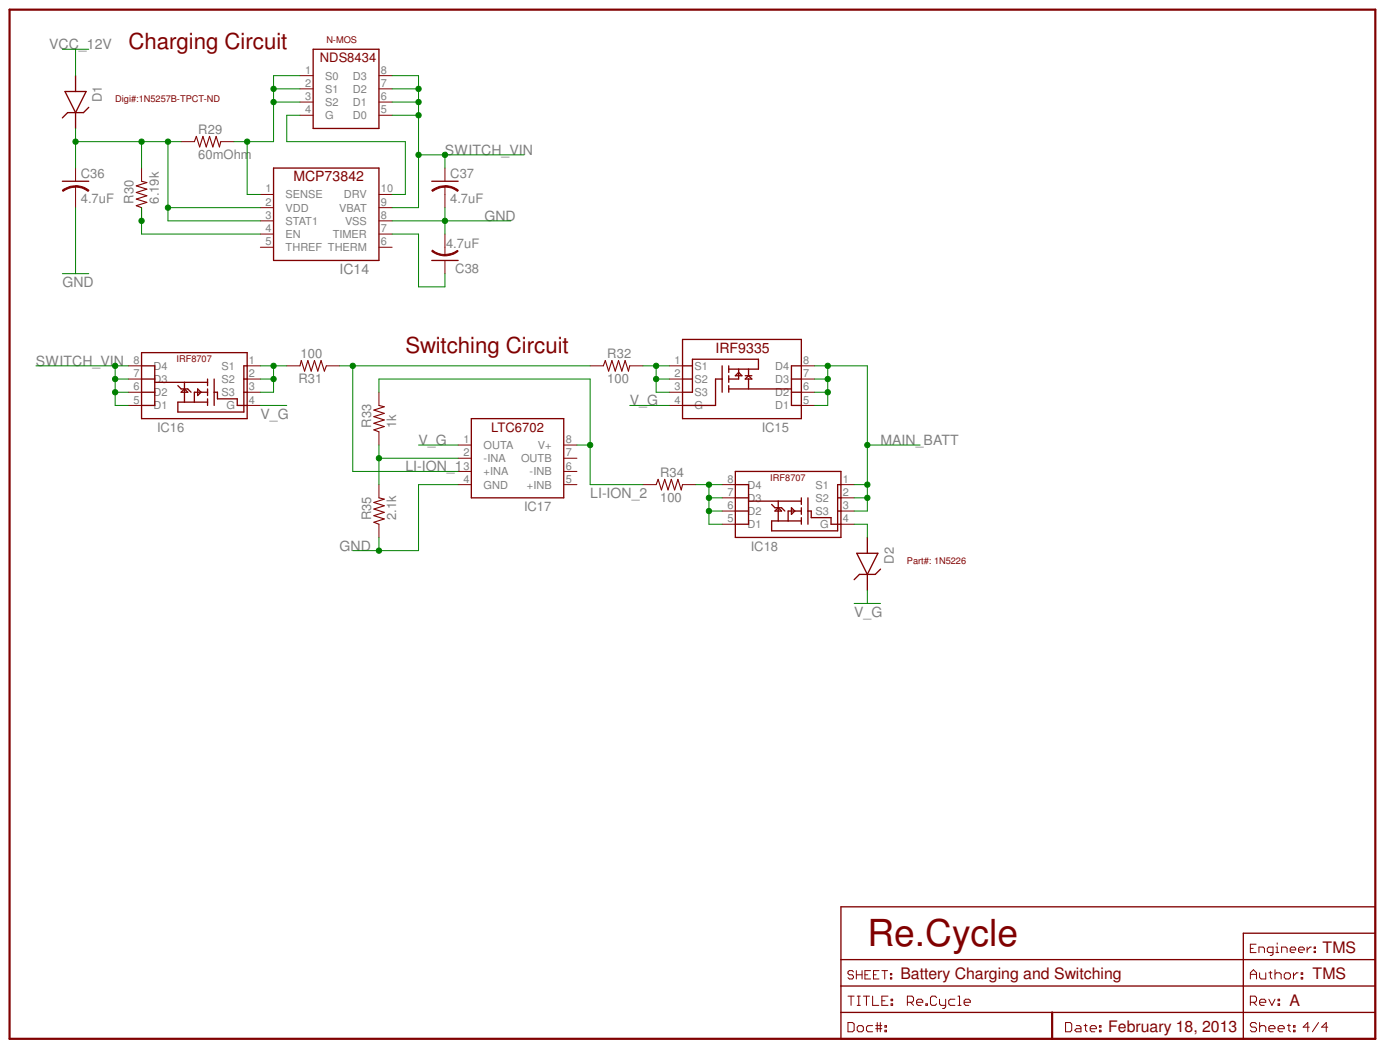
[picture p66: page 4]

IRF8707

Battery Charging and Switching
