tsukolsky/SeniorDesign/Files/FirstSemester/atmega128a_dev_sch.pdf

## ATMEGA128A uC BeagleBone P8 Header

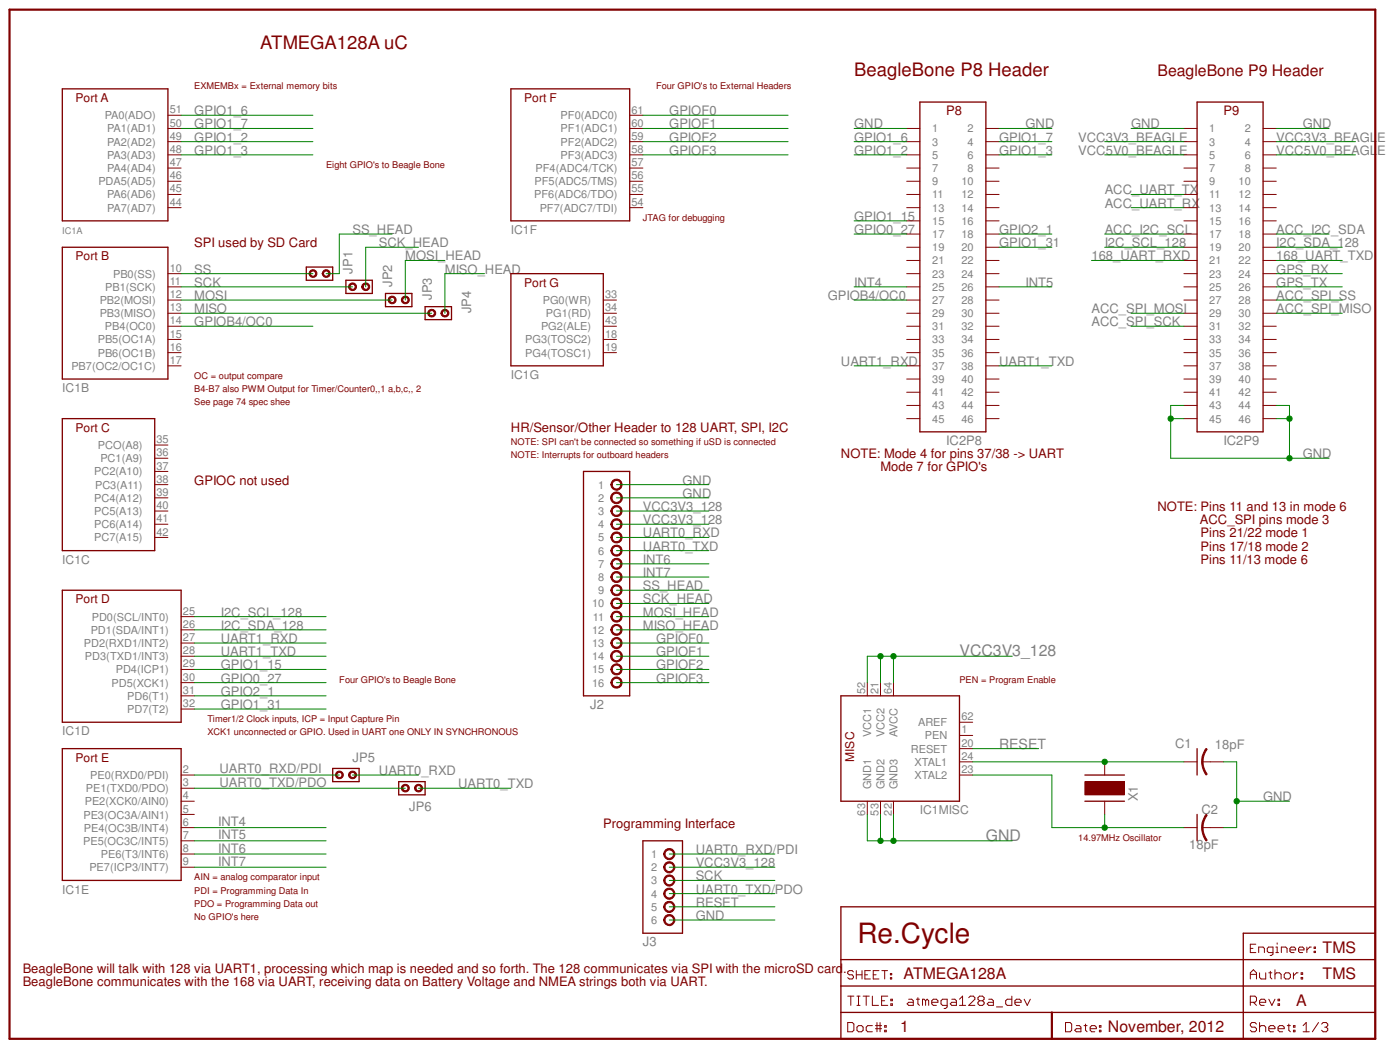
[picture p67: page 1]

Eight GPIO's to Beagle Bone

SPI used by SD Card

OC = output compare
B4-B7 also PWM Output for Timer/Counter0,,1 a,b,c,, 2
See page 74 spec shee

HR/Sensor/Other Header to 128 UART, SPI, I2C
NOTE: SPI can't be connected so something if uSD is connected

NOTE: Pins 11 and 13 in mode 6

Four GPIO's to Beagle Bone

BeagleBone will talk with 128 via UART1, processing which map is needed and so forth. The 128 communicates via SPI with the microSD card.
BeagleBone communicates with the 168 via UART, receiving data on Battery Voltage and NMEA strings both via UART.

ATMEGA168A uC | Programming Header-168

## SPI Header from HR/Sensors/Other to 168

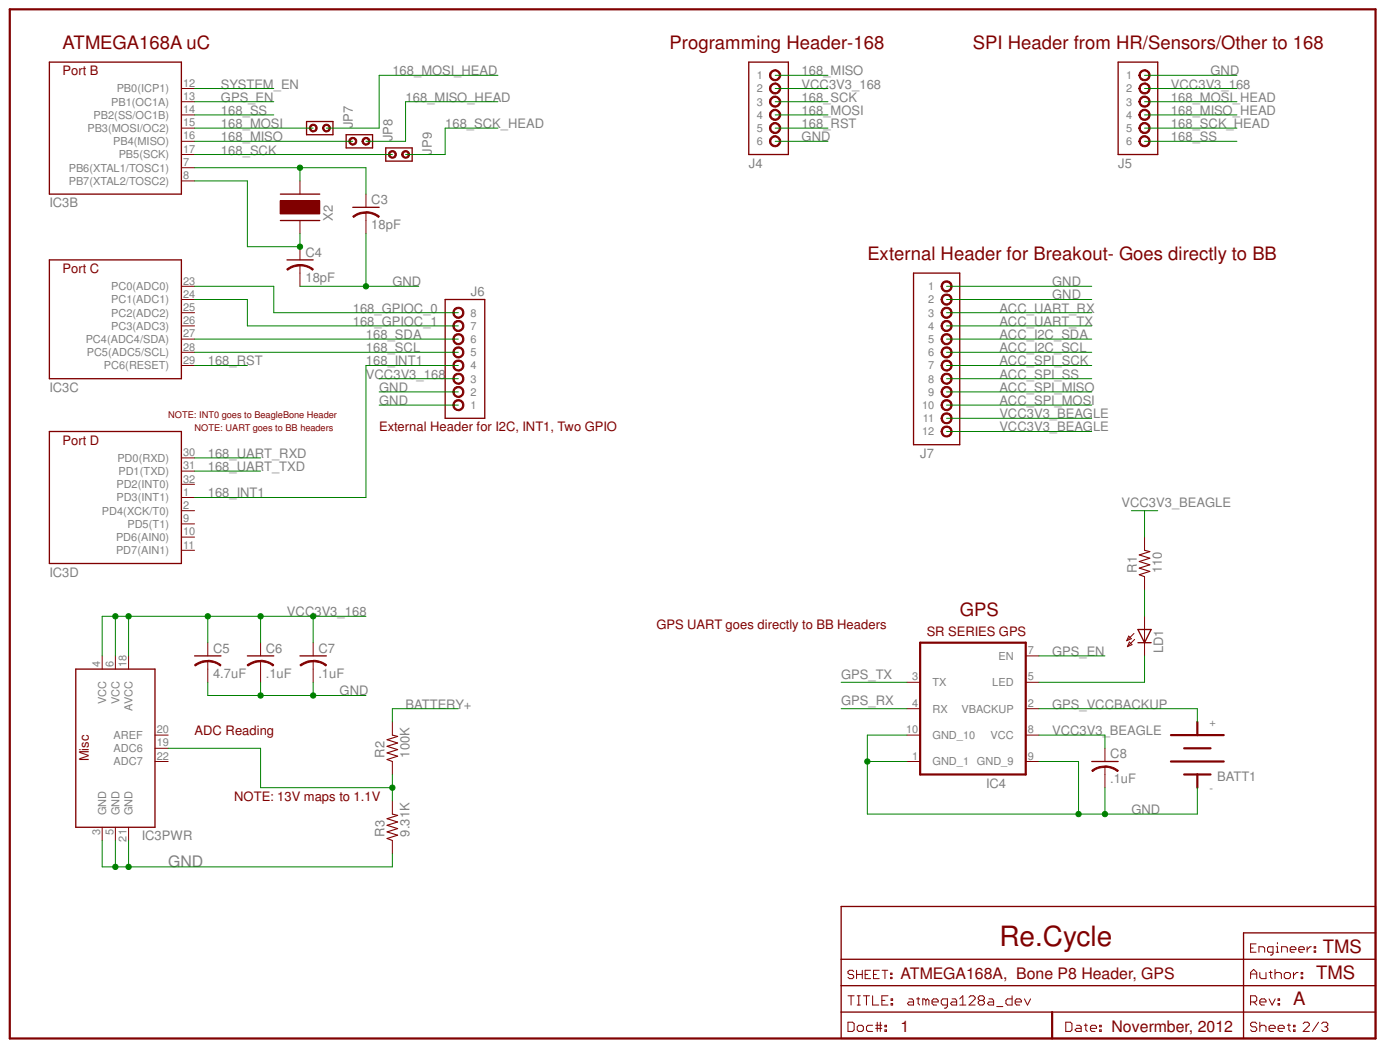
[picture p68: page 2]

External Header for Breakout- Goes directly to BB

NOTE: INT0 goes to BeagleBone Header
NOTE: UART goes to BB headers
168_UART_RXD
168_UART_TXD

External Header for I2C, INT1, Two GPIO

GPS UART goes directly to BB Headers

## 12V Power

## 5v0 to 3v3 regulator for AT168

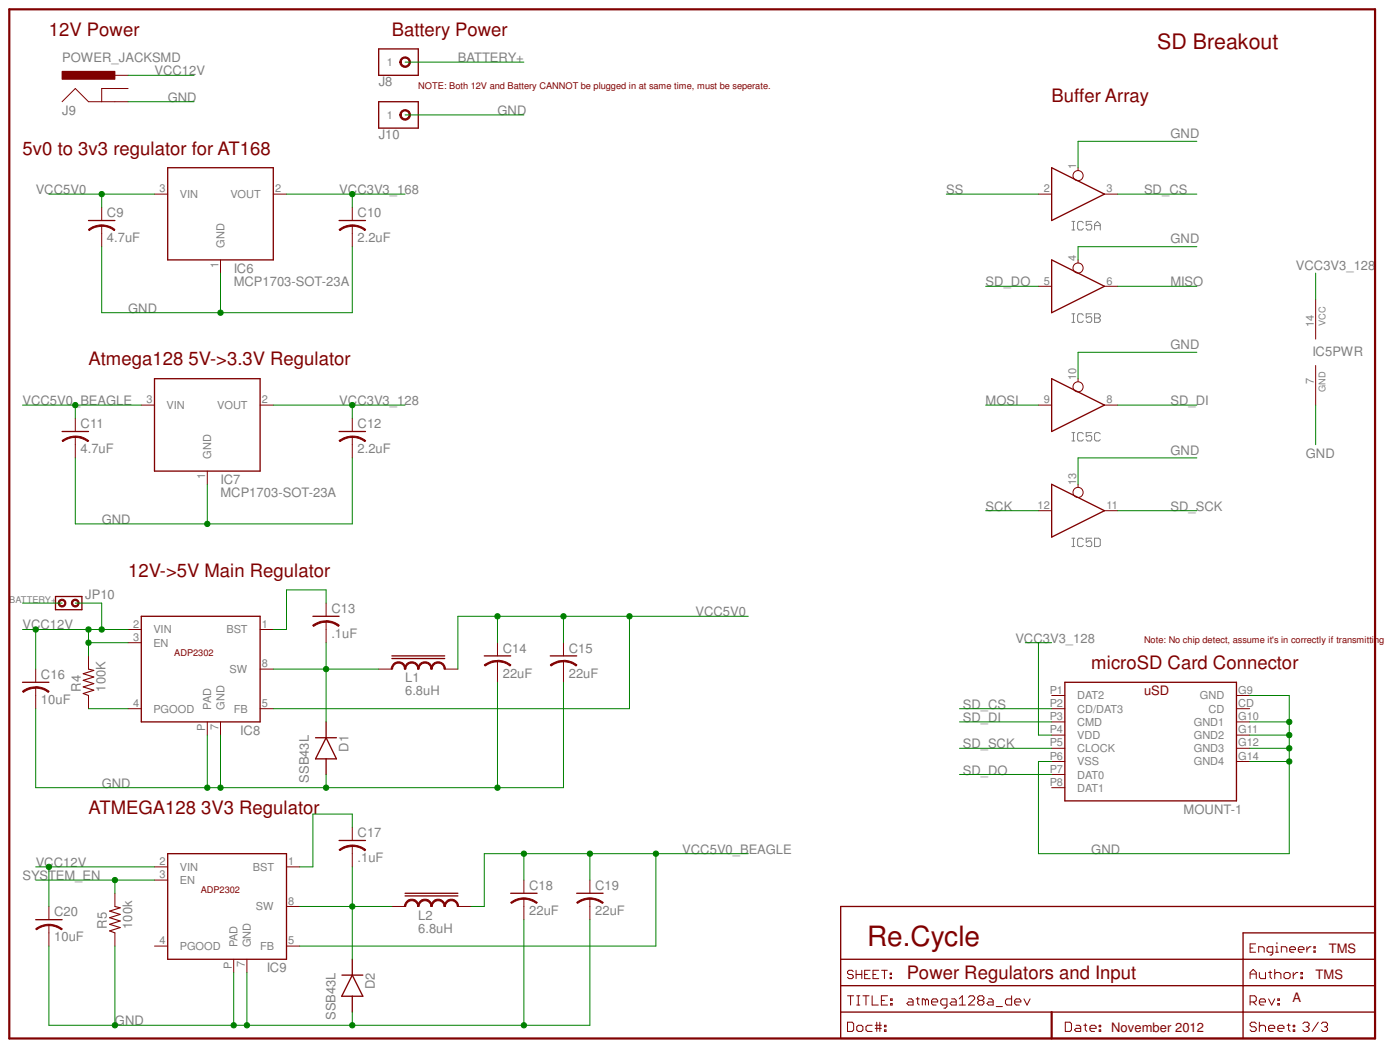
[picture p69: page 3]

NOTE: Both 12V and Battery CANNOT be plugged in at same time, must be seperate.

Note: No chip detect, assume it's in correctly if transmitting

Power Regulators and Input
