tsukolsky/SeniorDesign/ResourceCD/Team14-ECE464 2013/Hardware Documentation/Schematics and PCB/Re.Cycle_bottom.pdf

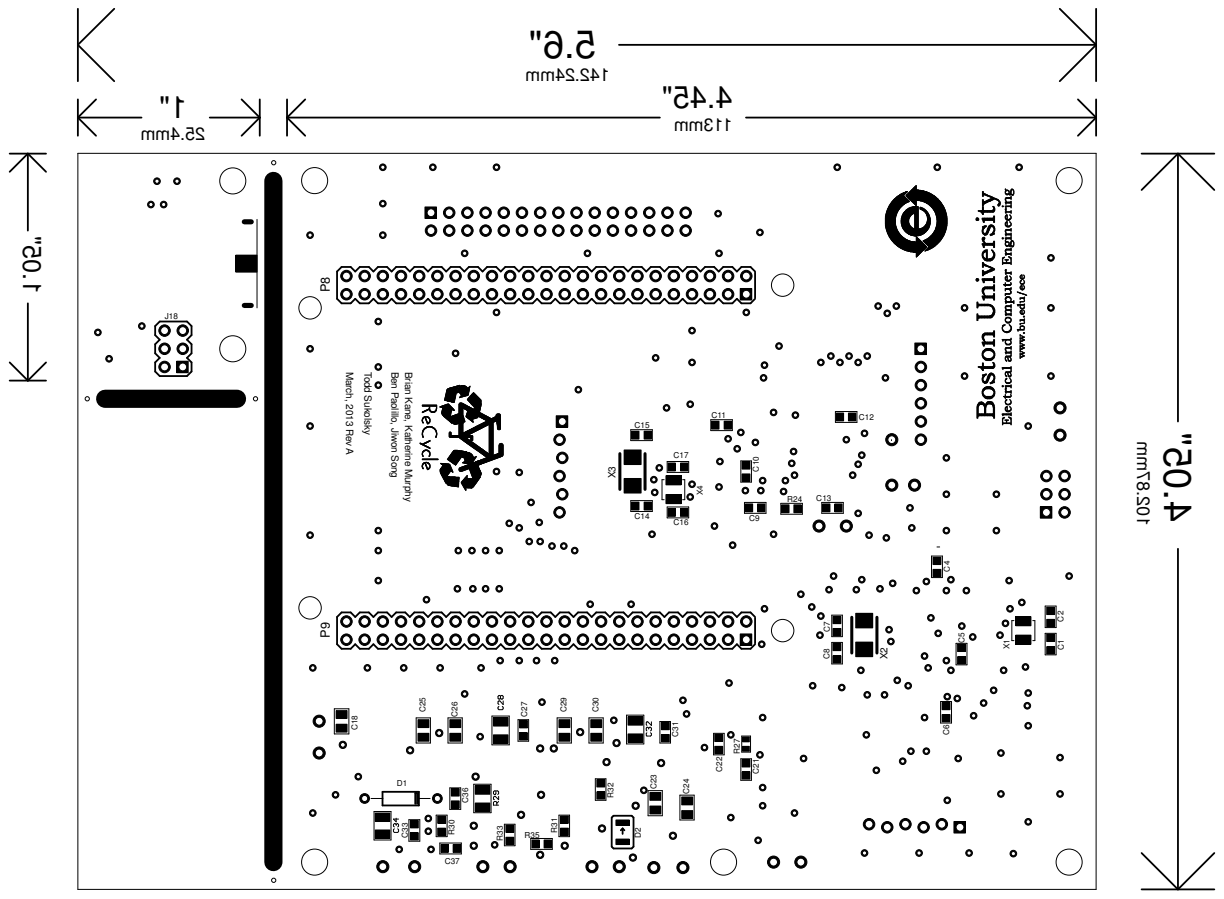
[picture p70: page 1]

Ben Paolillo, Jiwon Song

Brian Kane, Katherine Murphy
