tsukolsky/SeniorDesign/Files/FirstSemester/atmega128a_dev_bottom.pdf

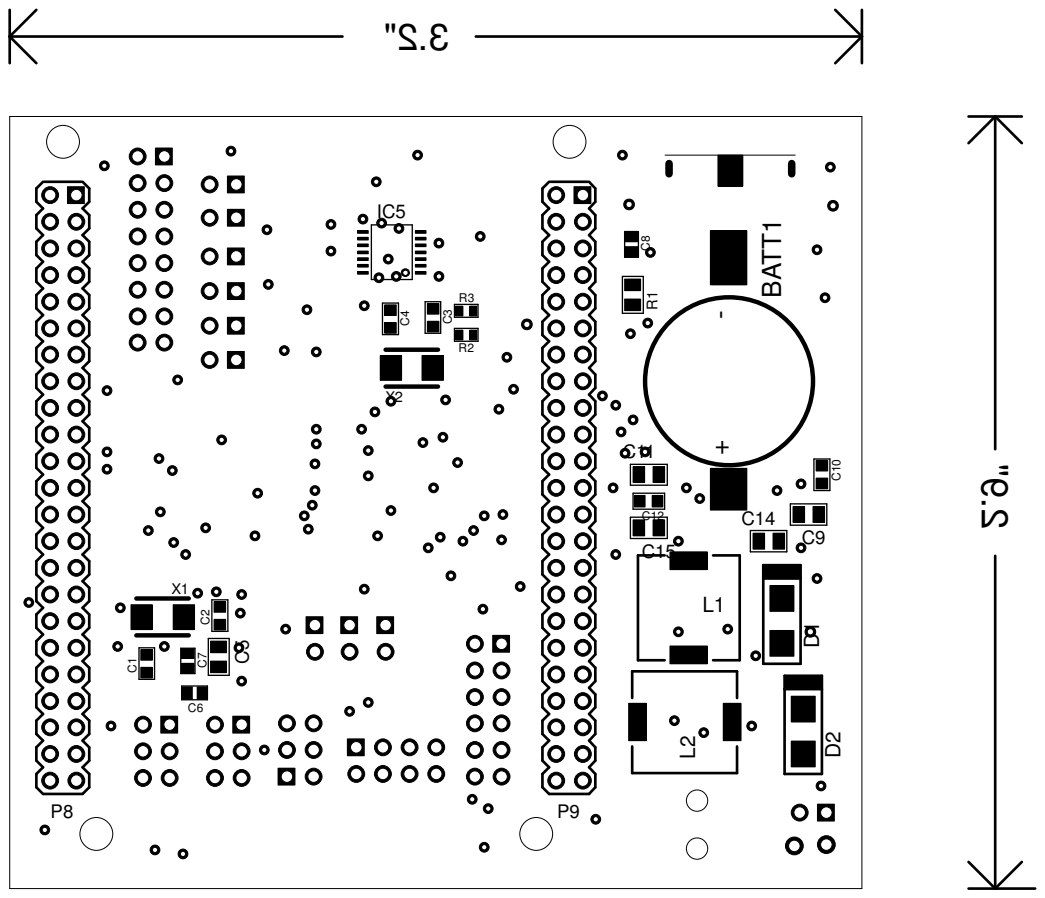
[picture p72: page 1]
