tsukolsky/SeniorDesign/Files/FirstSemester/atmega128a_dev_top.pdf

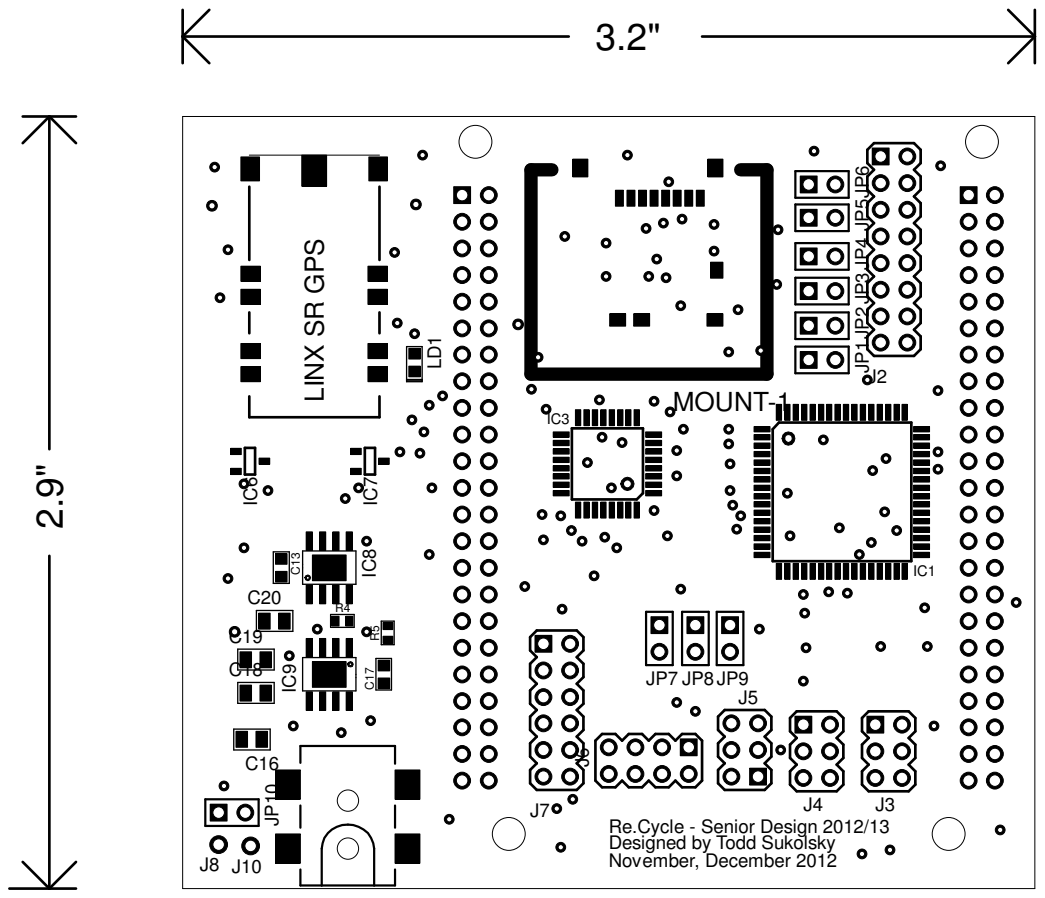
[picture p73: page 1]

Re.Cycle - Senior Design 2012/13
Designed by Todd Sukolsky
November, December 2012
