tsukolsky/SeniorDesign/ResourceCD/Team14-ECE464 2013/Software Documentation/Source Code/Graphics AVR/GAVR/GAVR_reCycle/Graphics_lib/ILI932X_param.h

// Some macros for commands/regs for ILI9325 controller
#ifndef ILI932X_param_H
#define ILI932X_param_H

// LCD controller chip identifiers (the only 2 we should need)
#define ID_932X    0
#define ID_UNKNOWN 0xFF

// Register names from Peter Barrett's Microtouch code
// Not including for all chips; unnecessary overhead for ReCycle
// (Reducing flexibility to save memory, since this will only be used
//  for this one project)
#define ILI932X_START_OSC          0x00
#define ILI932X_DRIV_OUT_CTRL      0x01
#define ILI932X_DRIV_WAV_CTRL      0x02
#define ILI932X_ENTRY_MOD          0x03
#define ILI932X_RESIZE_CTRL        0x04
#define ILI932X_DISP_CTRL1         0x07
#define ILI932X_DISP_CTRL2         0x08
#define ILI932X_DISP_CTRL3         0x09
#define ILI932X_DISP_CTRL4         0x0A
#define ILI932X_RGB_DISP_IF_CTRL1  0x0C
#define ILI932X_FRM_MARKER_POS     0x0D
#define ILI932X_RGB_DISP_IF_CTRL2  0x0F
#define ILI932X_POW_CTRL1          0x10
#define ILI932X_POW_CTRL2          0x11
#define ILI932X_POW_CTRL3          0x12
#define ILI932X_POW_CTRL4          0x13
#define ILI932X_GRAM_HOR_AD        0x20
#define ILI932X_GRAM_VER_AD        0x21
#define ILI932X_RW_GRAM            0x22
#define ILI932X_POW_CTRL7          0x29
#define ILI932X_FRM_RATE_COL_CTRL  0x2B
#define ILI932X_GAMMA_CTRL1        0x30
#define ILI932X_GAMMA_CTRL2        0x31
#define ILI932X_GAMMA_CTRL3        0x32
#define ILI932X_GAMMA_CTRL4        0x35
#define ILI932X_GAMMA_CTRL5        0x36
#define ILI932X_GAMMA_CTRL6        0x37
#define ILI932X_GAMMA_CTRL7        0x38
#define ILI932X_GAMMA_CTRL8        0x39
#define ILI932X_GAMMA_CTRL9        0x3C
#define ILI932X_GAMMA_CTRL10       0x3D
#define ILI932X_HOR_START_AD       0x50
#define ILI932X_HOR_END_AD         0x51
#define ILI932X_VER_START_AD       0x52
#define ILI932X_VER_END_AD         0x53
#define ILI932X_GATE_SCAN_CTRL1    0x60
#define ILI932X_GATE_SCAN_CTRL2    0x61
#define ILI932X_GATE_SCAN_CTRL3    0x6A
#define ILI932X_PART_IMG1_DISP_POS 0x80
#define ILI932X_PART_IMG1_START_AD 0x81
#define ILI932X_PART_IMG1_END_AD   0x82
#define ILI932X_PART_IMG2_DISP_POS 0x83
#define ILI932X_PART_IMG2_START_AD 0x84
#define ILI932X_PART_IMG2_END_AD   0x85
#define ILI932X_PANEL_IF_CTRL1     0x90
#define ILI932X_PANEL_IF_CTRL2     0x92
#define ILI932X_PANEL_IF_CTRL3     0x93
#define ILI932X_PANEL_IF_CTRL4     0x95
#define ILI932X_PANEL_IF_CTRL5     0x97
#define ILI932X_PANEL_IF_CTRL6     0x98

#define TFTLCD_DELAY 0xFF

#endif
