tsukolsky/SeniorDesign/ResourceCD/Team14-ECE464 2013/Software Documentation/Source Code/Graphics AVR/GAVR/GAVR_reCycle/trip.h

/*******************************************************************************\
| trip.h
| Author: Todd Sukolsky
| ID: U50387016
| Initial Build: 2/26/2013
| Last Revised: 4/7/2013
| Copyright of Todd Sukolsky and Boston University ECE Senior Design Team Re.Cycle, 2013
|================================================================================
| Description: This is a trip class that is used in the GAVR module. Calls things 
|	       from odometer class.
|--------------------------------------------------------------------------------
| Revisions:  2/26: Initial build
|			  2/28: Removed almost everything since it was a bad idea. Made this 
|					guy only inherit the heartMonitor and odometer class. Allows
|					the ability to test with only one of those files.
|			  4/7:  Changed some declarations and added some get functions for resetting trip
|					datas and such.
|================================================================================
| *NOTES: 
\*******************************************************************************/

#include <stdlib.h>
#include "odometer.h"
#include "heartMonitor.h"
#include "stdtypes.h"

using namespace std;

class trip: public odometer, public heartMonitor{
	public:
		trip();	
		void resetTrip();
		void setTripWOTime(double wheelSize);
		void setTripWTime(double wheelSize,unsigned int sDate, unsigned int sTime);
	private:
		unsigned int tripID;	
	
		
};

//Default/no-arg constructor
trip::trip():odometer(), heartMonitor(){
	//Do nothing in this, only important because it's a mix of heartMonitor and odometer.
	tripID=rand()%100+1;
}

void trip::resetTrip(){
	resetOdometer();
	hardResetHR();
}

void trip::setTripWOTime(double wheelSize){
	setNewOdometerWOtime(wheelSize);
	hardResetHR();
}

void trip::setTripWTime(double wheelSize, unsigned int sDate, unsigned int sTime){
	setNewOdometerWtime(wheelSize, sDate, sTime);
	hardResetHR();
}
