tsukolsky/SeniorDesign/ResourceCD/Team14-ECE464 2013/Software Documentation/Source Code/BeagleBone/setupScripts/gavrInterrupt.c

/*******************************************************************************\
| gavrInterrupt.c
| Author: Todd Sukolsky
| Initial Build: 4/16/2013
| Last Revised: 4/16/2013
|================================================================================
| Description: This module is a spin-off of commandCenter.c. It is used to 
|	alert the BeagleBone that the GAVR is sending it something. Blocks on read.
|	Forks to call ReceiveGAVR which will call SendGAVR
|--------------------------------------------------------------------------------
| Revisions:
|================================================================================
| *NOTES:Polling example found at: http://bwgz57.wordpress.com/tag/beaglebone/
\*******************************************************************************/
#include <stdio.h>
#include <stdlib.h>
#include <string.h>
#include <unistd.h>
#include <sys/wait.h>
#include <errno.h>
#include <fcntl.h>
#include <poll.h>
#include "pollingExtras.h"

void error(const char *msg);
void handleInterrupt(void);

int main(){
	//Declare a file descriptor and open the file we need as read only.
	int fd;
	fd = open("/sys/class/gpio/gpio34/value", O_RDONLY);		//this is the file for GAVR request to come in.
	struct pollfd pfd;
	//Intiailize polling file as the file descriptor	
	pfd.fd = fd;
	pfd.events = POLLPRI;
	pfd.revents = 0;
	//Lead is what the current pin is set to, ready is how many times this guy has been activated.
	int lead,lastLead,ready;
	lastLead=get_lead(fd);
	while (1) {
		ready = poll(&pfd, 1, -1);
		printf("ready: %d\n", ready);
		if (pfd.revents != 0) {	//if an event happened and the pin is a 1, that means we got an interrupt from GAVR
			lead=get_lead(fd);
			printf("Calling interrupt handler()");
			handleInterrupt();
			lastLead=lead;
		}	
	}
	return 0;
}
/****************************
error:
****************************/
void error(const char *msg){
	perror(msg);
}

/****************************
handleInterrupt()
****************************/
void handleInterrupt(){
	int pid2, pipes[2];
	pipe(pipes);
	pid2=fork();
	if (pid2<0){
		error("Error starting \"RecieveGAVR\" process.\n");
	} else if (pid2==0){//child process	
		//Declare arguments and setup the pipe to see communications
		char *args[]={"/home/root/Documents/beagle-bone.git/CommScripts/ReceiveGAVR.py",0};
		//Close STDIN of pipe, duplicate STDOUT and STDERR as the output end of pipe.		
		/*close(pipes[0]);
		dup2(pipes[1],1);
		dup2(pipes[1],2);*/
		execv(args[0],args);
		error("Unable to exec ReceiveGAVR.");
	} else { //Parent
		/*dup2(pipes[0],0);
		close(pipes[1]);*/
		waitpid(pid2,NULL,0);
	}//end of fork, go back to blocking
}
