tsukolsky/SeniorDesign/(commit log)

2013-02-26 Speed sensor works, HR sensor in the midst
2013-02-26 Tweaked HR code, needed to enable ADC
2013-02-28 Made new <heartMonitor.h> class and updated trip and odometer class. No compiler errors. I think it should work, need to tweak HR code still and add fail safes to both hr and speed stuff
    [HR_TEST.cpp, heartMonitor.h, odometer.h, trip.h]
2013-02-28 Newest schematics
2013-03-01 Idk what I changed, resolved merge conflict though
    [HR_TEST.cpp]
2013-03-01 Added UML's for classes and tweaked HR code. PCB is ordered as well
2013-03-04 Tryhing to figure out HR with better accuracy. Trying a different method where we sample for ~1.5seconds, then look for maximum values of the voltage...not getting accurate readings
2013-03-04 Changed some more HR stuff. Almost ahve it figured out. need to change algorithm slightly to avoid dichotic noise
    [HR_TEST.cpp, heartMonitor.h]
2013-03-04 Added PNG's for powerpoint. Made initial Critical Design review slides. Added Concept Design review powerpoint.
2013-03-04 Added WAVR->GAVR functionality in GAVR modules. Also moved some more uart stuff to myUart.h
2013-03-04 FInished Critical slides with trip flow and data structure
    [EEPROMstructure.xlsx]
2013-03-05 FInished comm protocol for Bone to WAVR and cleaned it up, fixed some timeout things.
    [WAVR.cpp, myUart.h]
2013-03-05 Ordered sample parts
2013-03-06 Added first semester stuff, added powerpoint for CDR. Many mistakes in slides
2013-03-14 Tweaks to UART transmission between {Bone,WAVR} and {WAVR, GAVR} where the logic is based on {Sender, Receiver}
2013-03-23 Starting to test PCB
2013-03-24 Successfully programmed and got ASYNC timer to work on GAVR, basically proves major functionality. Unable to grab address of WAVR, think the leads arent tied down all the way. Resoldering tomorrow
2013-03-24 Almost got preliminary power managment testing complete and working. LCN_EN not going high to 3.3V, only going to 1.6V, somewhere there is a crippling factor.
    [TcfTransactionLog.csv]
2013-03-25 Finished soft debug of board. Battery switching and power management testing complete and stable.
2013-03-26 Added/completed main integration of PCBtest.cpp and WAVR.cpp, next is add WAVR receive uart protocol from GAVR
2013-03-26 Finished preliminary WAVR receive from GAVR (see myUart.h) and some minor tweaks to main file. Need to test now and add timeout feature in main Timer2 overflow. .See Revisions in myUart.h and WAVR.cpp
2013-03-27 Small tweaks, currently writing date integration for string
2013-03-27 Finished ReceiveGAVR() in myUart.h...see revisions in WAVR.cpp and myUart.h. Need to tweak one small thing in SendGAVR() protocol in main and uart files, see WAVR.cpp->Notes(1)
2013-03-27 Got the main program and myUart.h to sync correctly. flags should be ready for logic manipulation. Now time to write send/receive protocols
    [ATmega2560.h, ATmegaXX4PA.h, GAVR_reCycle.cpp, WAVR.cpp, myUart.h]
2013-03-28 Looked over uart tranmissions and receptions, logic is now sound there and in main file. Added some new flags; now mirrors WAVRs SendGAVR() routine. Started small work on eepromSaveRead.h for TRIP EE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
2013-03-31 Trying to debug board. Issues with virtual machine build
    [ATmegaXX4PA.h, WAVR.cpp, eepromSaveRead.h]
2013-04-01 Testing of circuitboard was interesting. Everything works so far in this module as far as power management and interrupts being triggered. No UART was initiated. There is some bug in the WAVR circuit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
    [WAVR.cpp, eepromSaveRead.h]
2013-04-02 Got startup sequence working correctly. Changed which oscillators are being used. GAVR uses 8MHz, WAVR uses 1MHz. only thing needed to change in startup is the recognition of GPIO line for the GAVR->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
    [WAVR.cpp, pcbTest.cpp]
2013-04-02 New schematic pdf of top with added measurements for Casing CAD
2013-04-02 Updated GAVR with trip, odometer, hrMonitor headers. Changed way it should work to a debugging mode, no actual sending and receiving, just knowing what it should do. WAVR has been updated to try and 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
    [GAVR_reCycle.cpp, HR_TEST.cpp, WAVR.cpp, heartMonitor.h, myTime.h, myUart.h, odometer.h, pcbTest.cpp]
2013-04-04 FInished soldering all parts onto board. Accidentally killed ATmega644PA on board numero 2. Need to lift and replace with 324PA. Something still wrong with GAVR&GPS3.3v regulator, possibly needs to b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
    [WAVR.cpp, pcbTest.cpp]
2013-04-05 BeagleBone to WAVR works, very slow though. Limited by AVR's. Working on getting UART working for WAVR<->GAVR. Interrupt registered, not getting a SYN though. Obviously not sending correctly to WAVR.
    [GAVR_reCycle.cpp, WAVR.cpp, myUart.h]
2013-04-06 Started getting WAVR->GAVR working. Didn't have the USART1 powered in the WAVR which was holding things up. Getting ACKERROR or Unknown ACKS at the moment.
    [GAVR_reCycle.cpp, WAVR.cpp, myUart.h]
2013-04-07 Worked more on UART tranmission. Got WAVR->GAVR Communicaiton to work, receiving correct string ack string on WAVR<-GAVR, but the module is'nt recognizing the '.' and then has a timeout since nothing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
    [GAVR_reCycle.cpp, WAVR.cpp, eepromSaveRead.h, myUart.h]
2013-04-09 Added ReceiveBone2 and revised SendBone. Tweaked some internal code in LCDinput section, it's currently uncommented. Implemented a vector funtionality in myVector.h. Got the header from the internet 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
    [TcfTransactionLog.csv]
2013-04-14 Fixed race conditino when date/time is not working correctly. Sometimes happens when tehre is a short. Need to change the name of these things so they match whcih controller they are for.
    [myUart.h]
2013-04-14 Worked on main, uart and eeprom. Going to try new heartRate detection and fix NAN error. Added user interaction capabilities
    [GAVR_reCycle.cpp, eepromSaveRead.h, heartMonitor.h, myUart.h]
2013-04-14 Tested myVector class, works as long as correct libraries are given. Moved all test scripts into a folder.
    [hrCodeTest.cpp, myVector.h, tiHR.c, vectorTest.cpp]
2013-04-15 Got method working, need to add bump case
2013-04-15 Lots of work. Added a few cases for SendBone() and ReceiveeBone(). Changed functionality to accept UART2 from BeagleBone.
2013-04-19 Fixed NAN scenario in GAVR, had an issue ith EEPROM. See eepromSaveRead.h in the gavr folder. Added functionality to TEST so that communication protocols aren't sparked by startup timeouts. Added dua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
    [ATmega2560.h, GAVR_reCycle.cpp, WAVR.cpp, eepromSaveRead.h, gavrUart.h, heartMonitor.h]
2013-04-19 Should have fixed issue with average speed
    [odometer.h]
2013-04-20 Finished all prototype work for GAVR and WAVR. Something is wrong with the ReceiveBone2 protocol. Loops in state 1 continuously, never receives anything. Might be a bracket error or overflow/no break.
    [GAVR_reCycle.cpp, WAVR.cpp, gavrUart.h]
2013-04-22 Functions that don't work for comm ith beagle/haven't been tested are view usb, offload usb, and delete usb. Delete usb works, just don't know what you're deleteing. Offload usb will also work. Issue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
    [GAVR_reCycle.cpp, eepromSaveRead.h, gavrUart.h, odometer.h]
2013-04-22 Tweaked receivebone and receive bone2 and sendbone to offload trips correctly. Offloading works now. Only things left to resolve is display usb trips, need file structure to hold string in heap memor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
    [GAVR_reCycle.cpp, gavrUart.h]
2013-04-23 Small change to HR sensing fncationality. Now waits for mod7 of currentSeconds to initiate sensing, then timer is enabled and collects samples until the 300 has been done. At that point timer is kill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
2013-04-24 Funcational testing code. Now has working heart rate monitor, dynamic switching. See header in heartMonitor.h. Need to add comments to the code to make it sensible. All receive functions still work. 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
2013-04-29 Added everyting for the Resource CD except for the Engineering Addendum. Will do that tomorrow.
    [Assembly.SLDASM, Base.SLDPRT, Shelf.SLDPRT, Top.SLDPRT, Wall 1.SLDPRT, Wall 2, holes.SLDPRT, Wall 2.SLDPRT, Wall 3.SLDPRT]
2013-05-05 Added ECE powerpoint with my slides completed along with Ben's it looks like
